ComEngineering/Monitoring_Hardware/Project_PCB/Monitoring_TECO_rev2/DOC/image/BOTT_BACK_view_front.png

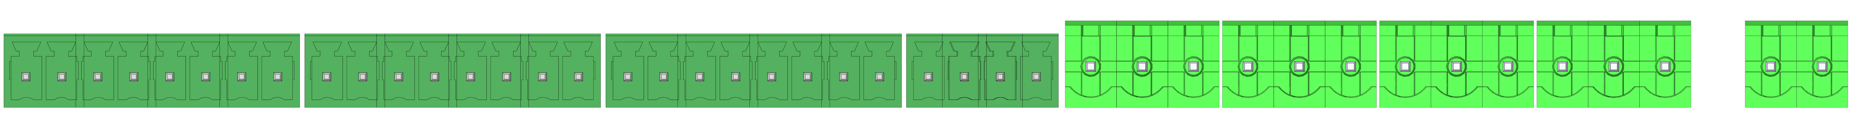
Project_PCB/Monitoring_TECO_rev2/DOC/image/BOTT_BACK_view_front.png
