ComEngineering/Monitoring_Hardware/Project_PCB/Monitoring_TECO_rev2/DOC/image/SM-MOTHB_view_top.png

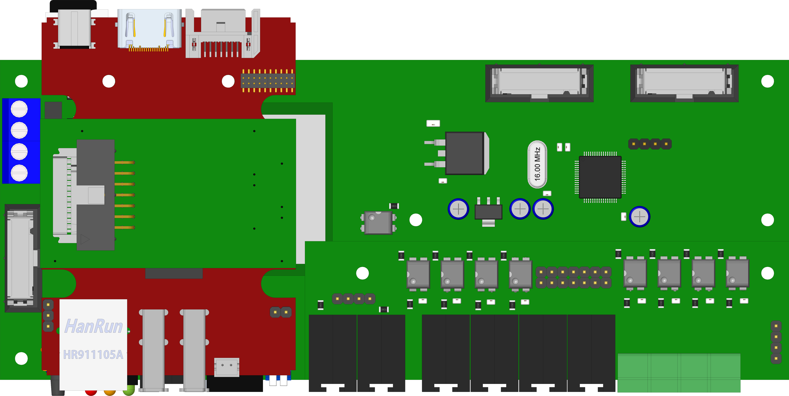
Project_PCB/Monitoring_TECO_rev2/DOC/image/SM-MOTHB_view_top.png
