ComEngineering/Monitoring_Hardware/Project_PCB/Monitoring_TECO_rev2/DOC/image/zGPIO_rev2.png

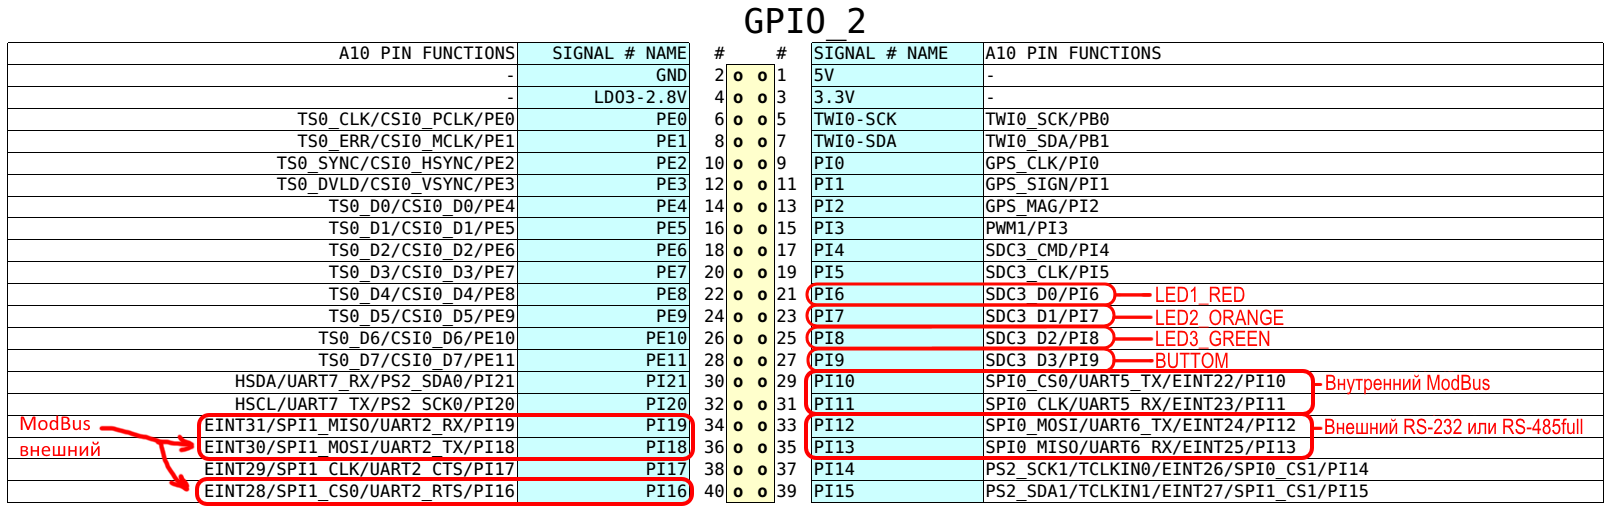
Project_PCB/Monitoring_TECO_rev2/DOC/image/zGPIO_rev2.png
