ComEngineering/Monitoring_Hardware/Project_PCB/Monitoring_TECO_rev2/DOC/Price_SM-DCP4.DCS14 rev. 2.xlsx

Designator | Description | Footprint | Comment | Количество | Цена UAH | Сумма
K1, K2, K3, K4 | 7A 240Vac 1 pole Slim relay | BS-115C-12A | JQC-3F-DC12VH-15A | 4 | 11.25 | 45 | http://www.kosmodrom.com.ua/el.php?name=JQC-3F-DC12VH-15A
K5, K6, K7, K8, K9, K10, K11, K12, K13, K14, K15, K16, K17, K18 | 1A, 10Vdc, 1 pole, SIP terminal | R_BRS | BRS-1A12 | 14 | 25.75 | 360.5 | http://www.kosmodrom.com.ua/el.php?name=BRS-1A12
P1, P2 | IDC/BH | BH-14 | BH-14 | 2 | 1.5 | 3 | http://www.kosmodrom.com.ua/el.php?name=BH-14
U1, U2, U3 | Darlington Transistor Arrays | SO-16_N | ULN2003A | 3 | 3.75 | 11.25 | http://www.kosmodrom.com.ua/prodlist.php?page=0&name=ULN2003A
X1, X2, X3 | Connector 3.5mm | MC_3.5_8 | 15EDGRC-3.5-08P | 3 | 11.25 | 33.75 | http://www.kosmodrom.com.ua/el.php?name=15EDGRC-3.5-08P-14-00AH
X1, X2, X3 | Connector 3.5mm | MC_3.5_8 | 15EDGK-3.5-08P | 3 | 25.75 | 77.25 | http://www.kosmodrom.com.ua/prodlist.php?name=15EDGK-3.5
X4 | Connector 3.5mm | MC_3.5_4 | 15EDGRC-3.5-04P | 1 | 5 | 5 | http://www.kosmodrom.com.ua/el.php?name=15EDGRC-3.5-04P-14-00AH
X4 | Connector 3.5mm | MC_3.5_4 | 15EDGK-3.5-02P | 1 | 7.5 | 7.5 | http://www.kosmodrom.com.ua/prodlist.php?name=15EDGK-3.5
X5, X6, X7, X8 | Connector 5mm | 2EDGR-5.0-03P | 2EDGR-5.0-03P | 4 | 4.5 | 18 | http://www.kosmodrom.com.ua/prodlist.php?name=2EDGR-5.0
X5, X6, X7, X8 | Connector 5mm | 2EDGK-5.0-03P | 2EDGK-5.0-03P | 4 | 12.25 | 49 | http://www.kosmodrom.com.ua/prodlist.php?name=2EDGK-5.0
X9 | Connector 5mm | 2EDGR-5.0-02P | 2EDGR-5.0-02P | 1 | 7.25 | 7.25 | http://www.kosmodrom.com.ua/prodlist.php?name=2EDGR-5.0
X9 | Connector 5mm | 2EDGK-5.0-02P | 2EDGK-5.0-02P | 1 | 8 | 8 | http://www.kosmodrom.com.ua/prodlist.php?name=2EDGK-5.0
X10 | Connector 5mm | 5mm 2 | DG305-5.0-02P | 1 | 3.5 | 3.5 | http://www.kosmodrom.com.ua/el.php?name=DG305-5.0-02P-12-00AH
 |  |  |  |  |  | 629
