ComEngineering/Monitoring_Hardware/Project_PCB/Monitoring_TECO_rev2/DOC/Price_SM-MOTHB rev. 2.xlsx

Designator | Description | Footprint | Comment | Value | Количество | Цена UAH | Сумма
C1, C5, C6, C7 | Capacitor semi | C_1206 | Cap_Semi | 0,47uF | 4 | 1 | 4 | http://www.kosmodrom.com.ua/prodlist.php?name=cap1206
C2, C42 | Capacitor semi | C_0805 | Cap_Semi | 10nF | 2 | 0.25 | 0.5 | http://www.kosmodrom.com.ua/prodlist.php?name=cap0805
C3 | Capacitor Polar | 8x11 | Cap_Polar | 100uF 25v | 1 | 0.75 | 0.75 | http://www.kosmodrom.com.ua/el.php?name=ECAP100MKF25VGS6.3X11
C4 | Capacitor Polar | 10x16 | Cap_Polar | 330uF 25v | 1 | 1.5 | 1.5 | http://www.kosmodrom.com.ua/el.php?name=ECAP330MKF25VKM10X12
C8, C11, C12, C13, C14, C16, C17, C18, C19, C20, C21, C22, C23, C24, C25, C26, C27, C28, C29, C30, C33, C34, C35, C36, C37, C38, C40, C41 | Capacitor semi | C_0805 | Cap_Semi | 0,1uF | 28 | 0.2 | 5.6 | http://www.kosmodrom.com.ua/prodlist.php?name=cap0805
C9, C10, C39, C43 | Capacitor polar | 5x11 | Cap_Polar | 10uF | 4 | 0.5 | 2 | http://www.kosmodrom.com.ua/el.php?name=ECAP10MKF63VSD5X11
C15, C31, C32 | Capacitor semi | C_0805 | Cap_Semi | 20pF | 3 | 0.25 | 0.75 | http://www.kosmodrom.com.ua/prodlist.php?name=cap0805
D1, D3 | Diode Schottky | SMC | VS-30BQ040 |  | 2 | 7.25 | 14.5 | http://www.kosmodrom.com.ua/prodlist.php?page=0&name=VS-30BQ040
D2, D4 | Supressor | SMB | SMBJ13A |  | 2 | 2.75 | 5.5 | http://www.kosmodrom.com.ua/el.php?name=SMBJ13A-TR
D5 | Diode Schottky | DO-201 | 1N5822 |  | 1 | 1.25 | 1.25 | http://www.kosmodrom.com.ua/prodlist.php?page=0&name=1N5822
D6, D7 | Diode Schottky | SOT-23_d | BAT54S |  | 2 | 0.5 | 1 | http://www.kosmodrom.com.ua/prodlist.php?page=0&name=BAT54S
D8, D9 | Supressor | SMB | SMBJ12CA |  | 2 | 3.5 | 7 | http://www.kosmodrom.com.ua/el.php?name=SMBJ12CA-TR
DS1 | LED | LED_RED | LED_RED |  | 1 | 0.75 | 0.75 | http://www.kosmodrom.com.ua/el.php?name=FYL-3004HD
DS2 | LED | LED_YELLOW | LED_YELLOW |  | 1 | 1.75 | 1.75 | http://www.kosmodrom.com.ua/el.php?name=FYL-3014UYC
DS3 | LED | LED_GREEN | LED_GREEN |  | 1 | 0.75 | 0.75 | http://www.kosmodrom.com.ua/el.php?name=FYL-3004GD
DS4, DS5, DS6, DS7 | LED_SMD | LED_SMD_0805 | LED_SMD_0805_Green |  | 4 | 2 | 8 | http://www.kosmodrom.com.ua/el.php?name=FYLS-0805PGC
F1, F2 | Fuse | Fuse RFTQ | RFTQ-2A |  | 2 | 4.25 | 8.5 | http://www.kosmodrom.com.ua/el.php?name=RFTQ-2A
L1 | Inductor | RCH-110 | RCH110NP-470K |  | 1 | 16.5 | 16.5 | http://www.kosmodrom.com.ua/el.php?name=RCH110NP-470K
P1, P2, P3 | IDC/BH | BH-14 | BH-14 |  | 3 | 1.5 | 4.5 | http://www.kosmodrom.com.ua/el.php?name=BH-14
R1 | Resistor | R_0805 | Resistor | 3,3K ±1% | 1 | 0.1 | 0.1 | http://www.kosmodrom.com.ua/prodlist.php?name=RES0805&page=1
R2, R3, R8, R30, R33, R36, R39, R42, R44, R47, R49 | Resistor | R_0805 | Resistor | 1K | 11 | 0.1 | 1.1 | http://www.kosmodrom.com.ua/prodlist.php?name=RES0805&page=0
R4, R16, R17, R21, R29, R32, R35, R38, R41, R43, R45, R48 | Resistor | R_0805 | Resistor | 10K | 12 | 0.1 | 1.2 | http://www.kosmodrom.com.ua/prodlist.php?name=RES0805&page=0
R5 | Resistor | R_0805 | Resistor | 24K ±1% | 1 | 0.1 | 0.1 | http://www.kosmodrom.com.ua/prodlist.php?name=RES0805&page=1
R6, R7, R11, R12 | Resistor | R_1206 | Resistor | 1R | 4 | 0.1 | 0.4 | http://www.kosmodrom.com.ua/prodlist.php?name=res1206
R9, R10 | Resistor | R_0805 | Resistor | 510R | 2 | 0.1 | 0.2 | http://www.kosmodrom.com.ua/prodlist.php?name=RES0805&page=2
R13, R19, R20, R23, R46 | Resistor | R_0805 | Resistor | 4,7K | 5 | 0.1 | 0.5 | http://www.kosmodrom.com.ua/prodlist.php?name=RES0805&page=2
R14, R15, R22, R24, R26 | Resistor | R_0805 | Resistor | 430R | 5 | 0.1 | 0.5 | http://www.kosmodrom.com.ua/prodlist.php?name=RES0805&page=2
R18, R25 | Resistor | R_0805 | Resistor | 2,2K | 2 | 0.1 | 0.2 | http://www.kosmodrom.com.ua/prodlist.php?name=RES0805&page=1
R27, R28 | Resistor | R_1206 | Resistor | 240R | 2 | 0.1 | 0.2 | http://www.kosmodrom.com.ua/prodlist.php?name=RES1206&page=1
R31, R34, R37, R40 | Resistor | R_0805 | Resistor | 2K | 4 | 0.1 | 0.4 | http://www.kosmodrom.com.ua/prodlist.php?name=RES0805&page=1
R50, R51, R52, R53 | Resistor | R_0805 | Resistor | 0R | 4 | 1 | 4 | http://www.kosmodrom.com.ua/prodlist.php?name=res1206
S1 | Swtich | Swich_TACTA-68N-F_ | TACTA-68N-F |  | 1 | 1.75 | 1.75 | http://www.kosmodrom.com.ua/el.php?name=TACTA-68N-F
S2 | DIP Switch_2 | Swich_DIP2 | SW DIP-2 |  | 1 | 5.5 | 5.5 | http://www.kosmodrom.com.ua/el.php?name=SWD3-2
U1 | Easy Switcher 3.0A Step-Down Voltage Regulator | D2PAK_5p | LM2596SX-ADJ |  | 1 | 50.75 | 50.75 | http://www.kosmodrom.com.ua/el.php?name=LM2596SX-ADJ
U2 | Voltage Regulators | D2PAK_3p | L7805ABD2T |  | 1 | 8.25 | 8.25 | http://www.kosmodrom.com.ua/el.php?name=L7805ABD2T-TR
U3 | Voltage Regulators 800mA | SOT-223_N | LD1117AS33TR |  | 1 | 2.5 | 2.5 | http://www.kosmodrom.com.ua/el.php?name=LD1117AS33TR
U4 | DC/DC converter | SIP4 | B1205S-1W |  | 1 | 63.5 | 63.5 | http://www.kosmodrom.com.ua/el.php?name=B1205S-1W
U5, U13, U14, U17, U18, U19, U20, U21, U22 | Optocoupler | DIP-4 | PC817C |  | 9 | 2 | 18 | http://www.kosmodrom.com.ua/el.php?name=PC817C
U6 | Dual Comparators | SO-8_L | LM393DR2G |  | 1 | 2.5 | 2.5 | http://www.kosmodrom.com.ua/el.php?name=LM393DR2G
U7 | DC/DC Regulated Single Output | NSD05 | NSD05-12S12 |  | 1 | 212 | 212 | http://psu.kiev.ua/p38435065-blok-pitaniya-mean.html
U8 | Optocoupler | DIP-8 | 6N137 |  | 1 | 10.5 | 10.5 | http://www.kosmodrom.com.ua/el.php?name=6N137
U9 | RS-485/RS-422 Transceiver | SO-8_N | ST485BDR |  | 1 | 7.75 | 7.75 | http://www.kosmodrom.com.ua/el.php?name=ST485BDR
U10, U12 | Dual-Channel Digital Isolators | SO-8_N | ADuM1201 |  | 2 | 25.5 | 51 | http://www.kosmodrom.com.ua/el.php?name=ADUM1201A
U11 | RS485/RS422 Differential driver and receiver pair | SO-8_L | SN75179B |  | 1 | 7.5 | 7.5 | http://www.kosmodrom.com.ua/el.php?name=SN75179BD
U15 | RS-232 Transceiver | SO-16_N | MAX3232EIDR |  | 1 | 22.5 | 22.5 | http://www.kosmodrom.com.ua/el.php?name=MAX3232EIDR
U16 | ARM Cortex-M0 32-bit MCU, 64 KB Flash, 8 KB Internal RAM, 55 I/Os, 64-pin LQFP, -40 to 85 degC, Tray | LQFP64_L | STM32F030R8T6 |  | 1 | 57.75 | 57.75 | http://www.kosmodrom.com.ua/el.php?name=STM32F030R8T6
VT1, VT2, VT3 | NPN | SOT-23_N | BC817 |  | 3 | 0.5 | 1.5 | http://www.kosmodrom.com.ua/el.php?name=BC817-40LT3G
X1, X2 | Connector 5mm | 5mm 2 | DG305-5.0-02P |  | 2 | 3.5 | 7 | http://www.kosmodrom.com.ua/el.php?name=DG305-5.0-02P-12-00AH
X4, X5, X6, X7 | Jumper | JUMPER-G | JUMPER-G |  | 4 | 0.5 | 2 | http://www.kosmodrom.com.ua/el.php?name=JUMPER-G
X3, X8, X11, X12 | Header, 14-Pin | ZL2029 | ZL2029 |  | 2 | 16.25 | 32.5 | http://www.kosmodrom.com.ua/el.php?name=ZL2029-20
X4, X5, X6, X7, X10 | Header, 16-pin | ZL201-16G | ZL201-16G |  | 1 | 16.25 | 16.25 | http://www.kosmodrom.com.ua/el.php?name=ZL201-16G
X9 | Connector 3.5mm | MC_3.5_8 | 15EDGRC-3.5-08P |  | 1 | 11.25 | 11.25 | http://www.kosmodrom.com.ua/el.php?name=15EDGRC-3.5-08P-14-00AH
X9 | Connector 3.5mm | MC_3.5_8 | 15EDGK-3.5-08P |  | 1 | 25.75 | 25.75 | http://www.kosmodrom.com.ua/prodlist.php?name=15EDGK-3.5
XS1, XS2, XS5, XS6, XS7, XS8 | TJ4-4P4C | RJ-11 - TJ4-4P4C | TJ4-4P4C |  | 6 | 4.5 | 27 | http://www.kosmodrom.com.ua/el.php?name=TJ4-4P4C
XS3 | TJ4-6P6C | RJ-12 - TJ4-6P6C | TJ4-6P6C |  | 1 | 4 | 4 | http://www.kosmodrom.com.ua/el.php?name=TJ4-6P6C
XS4 | Connector RJ-45 Simple | RJ-45 - TJ4-8P8C | TJ4-6P6C |  | 1 | 7.5 | 7.5 | http://www.kosmodrom.com.ua/el.php?name=TJ4-8P8C
ZQ1 | Crystal Oscillator | HC49S_3D | 8MHz |  | 1 | 5.5 | 5.5 | http://www.kosmodrom.com.ua/prodlist.php?page=0&name=HC49S
 | Connector IDC |  | AWP-14ZZ |  | 6 | 4.75 | 28.5 | http://www.kosmodrom.com.ua/el.php?name=AWP-14ZZ
 | Шлейф плоский |  | FLC-14 |  | 1 | 15.75 | 15.75 | http://www.kosmodrom.com.ua/el.php?name=FLC-14
 | RJ-11 Ответка |  | RJ11W-R |  | 12 | 1.5 | 18 | http://www.kosmodrom.com.ua/el.php?name=RJ11W-R
 | RJ-12 Ответка |  | RJ12W-R |  | 1 | 1.5 | 1.5 | http://www.kosmodrom.com.ua/el.php?name=RJ12W-R
 | RJ-45 Ответка |  | EMP881AR200 |  | 2 | 3 | 6 | http://www.kosmodrom.com.ua/el.php?name=EMP881AR200
 | Cтойка монтажная TP-15 пластиковая винт-гайка М3 |  | TP-15 |  | 4 | 3 | 12 | http://voron.ua/catalog/001230
 | Винт М3х08мм пластик молочный гол. полукруг |  | М3х08мм |  | 4 | 1 | 4 | http://voron.ua/catalog/016228
 | Гайка М3 шестигранная, пластиковая |  | М3 |  | 4 | 1 | 4 | http://voron.ua/catalog/016143
 | Держатель светодиода 3мм угловой одинарный |  |  |  | 3 | 0.36 | 1.08 | http://voron.ua/catalog/016137
P1 | IDC/BH | BH-14R | BH-14R |  | 1 | 4.75 | 4.75 | http://www.kosmodrom.com.ua/el.php?name=BH-14R
X1, X2, X3, X4 | Header, 20-Pin | PBD2-1.27-20-SMD | PBD2-20 |  | 4 | 5 | 20 | http://www.sea.com.ua/item/199202
 |  |  |  |  |  |  | 831.73
