ComEngineering/Monitoring_Hardware/Project_PCB/Monitoring_TECO_rev2/DOC/Price_SM-OW2.DI4.DCI4 rev. 2.xlsx

Designator | Description | Footprint | Comment | Value | Количество | Цена UAH | Сумма
C1, C2, C3, C4, C5, C6, C7, C8, C9, C10 | Capacitor semi | C_0805 | Cap_Semi | 0,1uF | 10 | 0.2 | 2 | http://www.kosmodrom.com.ua/prodlist.php?name=cap0805
D1, D2 | Diode Schottky | SOT-23_d | BAT54S |  | 2 | 0.5 | 1 | http://www.kosmodrom.com.ua/prodlist.php?page=0&name=BAT54S
DS1, DS2, DS3, DS4 | LED_SMD | LED_SMD_0805 | LED_SMD_0805_Green |  | 4 | 2 | 8 | http://www.kosmodrom.com.ua/el.php?name=FYLS-0805PGC
R1, R2 | Resistor | R_0805 | Resistor | 2,2K | 2 | 0.1 | 0.2 | http://www.kosmodrom.com.ua/prodlist.php?name=RES0805&page=1
R3, R6, R9, R12, R15, R17, R19, R21 | Resistor | R_0805 | Resistor | 10K | 8 | 0.1 | 0.8 | http://www.kosmodrom.com.ua/prodlist.php?name=RES0805&page=0
R4, R7, R10, R13, R16, R18, R20, R22 | Resistor | R_0805 | Resistor | 1K | 8 | 0.1 | 0.8 | http://www.kosmodrom.com.ua/prodlist.php?name=RES0805&page=0
R5, R8, R11, R14 | Resistor | R_0805 | Resistor | 2K | 4 | 0.1 | 0.4 | http://www.kosmodrom.com.ua/prodlist.php?name=RES0805&page=1
U1, U2, U3, U4, U5, U6, U7, U8 | Optocoupler | DIP-4 | PC817C |  | 8 | 2 | 16 | http://www.kosmodrom.com.ua/el.php?name=PC817C
X3 | Connector 3.5mm | MC_3.5_8 | 15EDGRC-3.5-08P |  | 1 | 11.25 | 11.25 | http://www.kosmodrom.com.ua/el.php?name=15EDGRC-3.5-08P-14-00AH
X3 | Connector 3.5mm | MC_3.5_8 | 15EDGK-3.5-08P |  | 1 | 25.75 | 25.75 | http://www.kosmodrom.com.ua/prodlist.php?name=15EDGK-3.5
XS1, XS2, XS3, XS4, XS5, XS6 | TJ4-4P4C | RJ-11 - TJ4-4P4C | TJ4-4P4C |  | 6 | 4.5 | 27 | http://www.kosmodrom.com.ua/el.php?name=TJ4-4P4C
 |  |  |  |  |  |  | 93.2
