ComEngineering/Monitoring_Hardware/Project_PCB/Monitoring_TECO_rev2/DOC/Закупка_Monitoring_TECO.xlsx

Designator | Description | Footprint | Comment | Value | Количество | Цена UAH | Сумма
C1, C5, C6, C48 | Capacitor semi | C_1206 | Cap_Semi | 0,47uF | 4 | 1 | 4 | http://www.kosmodrom.com.ua/prodlist.php?name=cap1206
C2, C43 | Capacitor semi | C_0805 | Cap_Semi | 10nF | 2 | 0.25 | 0.5 | http://www.kosmodrom.com.ua/prodlist.php?name=cap0805
C3 | Capacitor Polar | 8x11 | Cap_Polar | 100uF 25v | 1 | 0.75 | 0.75 | http://www.kosmodrom.com.ua/el.php?name=ECAP100MKF25VGS6.3X11
C4 | Capacitor Polar | 10x16 | Cap_Polar | 330uF 25v | 1 | 2 | 2 | http://www.kosmodrom.com.ua/el.php?name=ECAP330MKF25VKM10X12
C7, C10, C11, C12, C13, C14, C16, C17, C18, C19, C22, C23, C24, C25, C26, C27, C29, C31, C32, C33, C34, C35, C36, C37, C38, C39, C41, C42, C45, C46, C47 | Capacitor semi | C_0805 | Cap_Semi | 0,1uF | 31 | 0.2 | 6.2 | http://www.kosmodrom.com.ua/prodlist.php?name=cap0805
C8, C9, C40, C44 | Capacitor polar | 5x11 | Cap_Polar | 10uF | 4 | 0.75 | 3 | http://www.kosmodrom.com.ua/el.php?name=ECAP10MKF63VSD5X11
C15, C28, C30 | Capacitor semi | C_0805 | Cap_Semi | 20pF | 3 | 0.25 | 0.75 | http://www.kosmodrom.com.ua/prodlist.php?name=cap0805
C20, C21 | Capacitor Semi | C_0805 | Cap_Semi | 2,2nF | 2 | 0.25 | 0.5 | http://www.kosmodrom.com.ua/prodlist.php?name=cap0805
D1, D1.1 | Diode Schottky | SMC | VS-30BQ040 |  | 2 | 6.5 | 13 | http://www.kosmodrom.com.ua/prodlist.php?page=0&name=VS-30BQ040
D2, D3 | Supressor | SMB | SMBJ15A |  | 2 | 1.75 | 3.5 | http://www.kosmodrom.com.ua/el.php?name=SMBJ15A-TR
D4 | Diode Schottky | DO-201 | 1N5822 |  | 1 | 1.75 | 1.75 | http://www.kosmodrom.com.ua/prodlist.php?page=0&name=1N5822
D5, D6 | Diode Schottky | SOT-23_d | BAT54S |  | 2 | 0.5 | 1 | http://www.kosmodrom.com.ua/prodlist.php?page=0&name=BAT54S
D7, D8 | Supressor | SMB | SMBJ12CA |  | 2 | 3.25 | 6.5 | http://www.kosmodrom.com.ua/el.php?name=SMBJ12CA-TR
DS1, DS3 | LED | LED_RED | FYL-3004HD |  | 2 | 0.75 | 1.5 | http://www.kosmodrom.com.ua/el.php?name=FYL-3004HD
DS2 | LED | LED_GREEN | FYL-3004GD |  | 1 | 0.75 | 0.75 | http://www.kosmodrom.com.ua/el.php?name=FYL-3004GD
F1 | Fuse | Fuse RFTQ | RFTQ-2.5A |  | 1 | 4.25 | 4.25 | http://www.kosmodrom.com.ua/el.php?name=RFTQ-2.5A
F2, F3 | Fuse | Fuse RFTQ | RFTQ-0.16A |  | 2 | 5.5 | 11 | http://www.kosmodrom.com.ua/el.php?name=RFTQ-0.16A
F4, F5 | Fuse | Fuse RFTQ | RFTQ-1A |  | 2 | 4.25 | 8.5 | http://www.kosmodrom.com.ua/el.php?name=RFTQ-1A
K1, K2, K3, K4, K5, K6, K7, K8, K9, K10, K11, K12, K13, K14 | 1A, 10Vdc, 1 pole, SIP terminal | R_BRS | BRS-1A12 |  | 14 | 23.5 | 329 | http://www.kosmodrom.com.ua/el.php?name=BRS-1A12
K15, K16, K17, K18 | 7A 240Vac 1 pole Slim relay | BS-115C-12A | JQC-3F-DC12VH-15A |  | 4 | 10.25 | 41 | http://www.kosmodrom.com.ua/el.php?name=JQC-3F-DC12VH-15A
L1 | Inductor | RCH-110 | RCH110NP-470K |  | 1 | 15 | 15 | http://www.kosmodrom.com.ua/el.php?name=RCH110NP-470K
P1, P2, P3, P4, P5 | IDC/BH | BH-14 | BH-14 |  | 5 | 2.5 | 12.5 | http://www.kosmodrom.com.ua/el.php?name=BH-14
P6 | IDC/BH | BH-14R | BH-14R |  | 1 | 4.75 | 4.75 | http://www.kosmodrom.com.ua/el.php?name=BH-14R
R1 | Resistor | R_0805 | Resistor | 3,3K ±1% | 1 | 0.1 | 0.1 | http://www.kosmodrom.com.ua/prodlist.php?name=RES0805&page=1
R2, R3, R13, R15, R19, R23, R25, R27, R29, R31, R34, R36, R38, R40, R42, R44, R48, R51, R53 | Resistor | R_0805 | Resistor | 1K | 19 | 0.06 | 1.14 | http://www.kosmodrom.com.ua/prodlist.php?name=RES0805&page=0
R4, R12, R14, R16, R17, R18, R22, R24, R26, R28, R30, R33, R35, R37, R39, R41, R43, R47, R50, R54, R55, R56 | Resistor | R_0805 | Resistor | 10K | 22 | 0.1 | 2.2 | http://www.kosmodrom.com.ua/prodlist.php?name=RES0805&page=0
R5 | Resistor | R_0805 | Resistor | 24K ±1% | 1 | 0.1 | 0.1 | http://www.kosmodrom.com.ua/prodlist.php?name=RES0805&page=1
R6, R7, R10, R11 | Resistor | R_1206 | Resistor | 1R | 4 | 0.1 | 0.4 | http://www.kosmodrom.com.ua/prodlist.php?name=res1206
R8, R9 | Resistor | R_0805 | Resistor | 510R | 2 | 0.1 | 0.2 | http://www.kosmodrom.com.ua/prodlist.php?name=RES0805&page=2
R20, R21 | Resistor | R_0805 | Resistor | 3,9K ±1% | 2 | 0.1 | 0.2 | http://www.kosmodrom.com.ua/prodlist.php?name=RES0805&page=1
R32, R52, R59, R60, R61 | Resistor | R_0805 | Resistor | 360R | 5 | 0.1 | 0.5 | http://www.kosmodrom.com.ua/prodlist.php?name=RES0805&page=2
R45, R49 | Resistor | R_0805 | Resistor | 2,2K | 2 | 0.06 | 0.12 | http://www.kosmodrom.com.ua/prodlist.php?name=RES0805&page=1
R46 | Resistor | R_0805 | Resistor | 4,7K | 1 | 0.1 | 0.1 | http://www.kosmodrom.com.ua/prodlist.php?name=RES0805&page=2
R57, R58 | Resistor | R_1206 | Resistor | 240R ±1% | 2 | 0.14 | 0.28 | http://www.kosmodrom.com.ua/prodlist.php?name=RES1206&page=1
S1 | DIP Switch_2 | Swich_DIP2 | SWD3-2 |  | 1 | 5 | 5 | http://www.kosmodrom.com.ua/el.php?name=SWD3-2
S2 | Swtich | Swich_TACTA-68N-F_ | TACTA-68N-F |  | 1 | 1.5 | 1.5 | http://www.kosmodrom.com.ua/el.php?name=TACTA-68N-F
U1 | Easy Switcher 3.0A Step-Down Voltage Regulator | D2PAK_5p | LM2596SX-ADJ |  | 1 | 46.5 | 46.5 | http://www.kosmodrom.com.ua/el.php?name=LM2596SX-ADJ
U2 | Voltage Regulators 800mA | SOT-223_N | LD1117AS33TR |  | 1 | 2 | 2 | http://www.kosmodrom.com.ua/el.php?name=LD1117AS33TR
U3 | Voltage Regulators | D2PAK_3p | L7805ABD2T |  | 1 | 8 | 8 | http://www.kosmodrom.com.ua/el.php?name=L7805ABD2T-TR
U4 | DC/DC converter | SIP4 | B1205S-1W |  | 1 | 58.25 | 58.25 | http://www.kosmodrom.com.ua/el.php?name=B1205S-1W
U5, U8, U9, U10, U11, U12, U13, U14, U15, U18, U20, U21, U23, U24, U25, U26, U27 | Optocoupler | DIP-4 | PC817C |  | 17 | 2 | 34 | http://www.kosmodrom.com.ua/el.php?name=PC817C
U6 | Dual Comparators | SO-8_L | LM393DR2G |  | 1 | 2.25 | 2.25 | http://www.kosmodrom.com.ua/el.php?name=LM393DR2G
U7 | DC/DC Regulated Single Output | NSD05 | NSD05-12S12 |  | 1 | 195 | 195 | http://psu.kiev.ua/p38435065-blok-pitaniya-mean.html
U16 | ARM Cortex-M0 32-bit MCU, 64 KB Flash, 8 KB Internal RAM, 55 I/Os, 64-pin LQFP, -40 to 85 degC, Tray | LQFP64_L | STM32F030R8T6 |  | 1 | 50 | 50 | http://www.kosmodrom.com.ua/el.php?name=STM32F030R8T6
U17, U19, U22 | Darlington Transistor Arrays | SO-16_N | ULN2003A |  | 3 | 3.75 | 11.25 | http://www.kosmodrom.com.ua/prodlist.php?page=0&name=ULN2003A
U28 | Optocoupler | DIP-8 | 6N137 |  | 1 | 9.5 | 9.5 | http://www.kosmodrom.com.ua/el.php?name=6N137
U29 | RS-485/RS-422 Transceiver | SO-8_N | ST485BDR |  | 1 | 8.75 | 8.75 | http://www.kosmodrom.com.ua/el.php?name=ST485BDR
U30, U31 | Dual-Channel Digital Isolators | SO-8_N | ADuM1201 |  | 2 | 25.5 | 51 | http://www.kosmodrom.com.ua/el.php?name=ADUM1201A
U32 | RS485/RS422 Differential driver and receiver pair | SO-8_L | SN75179B |  | 1 | 7 | 7 | http://www.kosmodrom.com.ua/el.php?name=SN75179BD
X1, X2 | Connector 5mm | 5mm 2 | DG300-5.0-02P |  | 2 | 3.5 | 7 | http://www.kosmodrom.com.ua/el.php?name=DG300-5.0-02P-12-00AH
X3, X20, X13, X22 | Header, 4-Pin | PLS-4-3D | ZL2029 |  | 2 | 14.75 | 29.5 | http://www.kosmodrom.com.ua/el.php?name=ZL2029-20
X4, X5 | Header, 20-Pin | PBD2-1.27-20-SMD | PBD1.27-20-SMD |  | 2 | 5 | 10 | http://www.sea.com.ua/item/199202
X7, X8, X15, X19, X26 | Connector 3.5mm | MC_3.5_8 | 15EDGRC-3.5-08P |  | 5 | 10.5 | 52.5 | http://www.kosmodrom.com.ua/el.php?name=15EDGRC-3.5-08P-14-00AH
X10, X11, X12, X14 | Connector 5mm | 2EDGR-5.0-03P | 2EDGR-5.0-03P |  | 4 | 4 | 16 | http://www.kosmodrom.com.ua/prodlist.php?name=2EDGR-5.0
X16 | Header, 8-Pin | PLS-8-3D | ZL201-08G |  | 1 | 1.25 | 1.25 | http://www.kosmodrom.com.ua/el.php?name=ZL201-08G
X25 | Connector 3.5mm | MC_3.5_4 | 15EDGRC-3.5-04P |  | 1 | 4.5 | 4.5 | http://www.kosmodrom.com.ua/el.php?name=15EDGRC-3.5-04P-14-00AH
XS1, XS2, XS3, XS4, XS5, XS6, XS7, XS8, XS11, XS12, XS13, XS14 | TJ4-4P4C | RJ-11 | TJ4-4P4C |  | 12 | 3.75 | 45 | http://www.kosmodrom.com.ua/el.php?name=TJ4-4P4C
XS9, XS10 | TJ4-6P6C | RJ-12 | TJ4-6P6C |  | 2 | 3.5 | 7 | http://www.kosmodrom.com.ua/el.php?name=TJ4-6P6C
ZQ1 | Crystal Oscillator | 8.0 MHz | KX-3HE 8.0 MHz |  | 1 | 8.5 | 8.5 | http://www.kosmodrom.com.ua/prodlist.php?name=geyertermostab&page=0
 | Connector 5mm |  | 2EDGK-5.0-03P |  | 4 | 11.25 | 45 | http://www.kosmodrom.com.ua/prodlist.php?name=2EDGK-5.0
 | Connector 3.5mm |  | 15EDGK-3.5-04P |  | 1 | 14.75 | 14.75 | http://www.kosmodrom.com.ua/prodlist.php?name=15EDGK-3.5
 | Connector 3.5mm |  | 15EDGK-3.5-08P |  | 5 | 23.75 | 118.75 | http://www.kosmodrom.com.ua/prodlist.php?name=15EDGK-3.5
 | Connector IDC |  | AWP-14ZZ |  | 6 | 4.75 | 28.5 | http://www.kosmodrom.com.ua/el.php?name=AWP-14ZZ
 | Шлейф плоский |  | FLC-14 |  | 1 | 15.75 | 15.75 | http://www.kosmodrom.com.ua/el.php?name=FLC-14
 | Cтойка монтажная TP-18 пластиковая винт-гайка М3 |  | TP-15 |  | 3 | 3 | 9 | http://voron.ua/catalog/001230
 | Винт М3х08мм пластик молочный гол. полукруг |  | М3х08мм |  | 3 | 1 | 3 | http://voron.ua/catalog/016228
 | Гайка М3 шестигранная, пластиковая |  | М3 |  | 3 | 1 | 3 | http://voron.ua/catalog/016143
 | Держатель светодиода 3 мм угловой двойной |  |  |  | 1 | 0.6 | 0.6 | http://voron.ua/catalog/016138
 | Держатель светодиода 3мм угловой одинарный |  |  |  | 1 | 0.36 | 0.36 | http://voron.ua/catalog/016137
Итого |  |  |  |  |  |  | 1387
