ComEngineering/Monitoring_Hardware/Project_PCB/Monitoring_TECO/PCB_monitoring_Top_Front.step

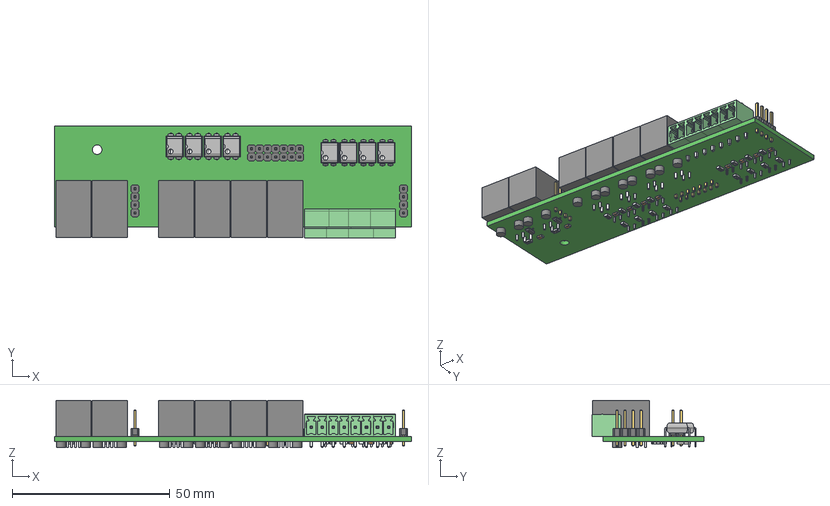
[picture p8: CAD file, 2015-11-30, an earlier design]
Project_PCB/Monitoring_TECO/PCB_monitoring_Top_Front.step
113.0 x 35.4 x 15.0 mm
Board
PLS-1 x 22
0805_SMD_Capacitor x 10
SOT-23 x 2
Resistor_0805 x 18
DIP-4_DEFAULT x 8
15EDGRC-3_5-2 x 4
Extruded x 6
