ComEngineering/Monitoring_Hardware/(list of files, cad)

Other CAD files:
Project_PCB/Monitoring_TECO_rev2/z_Bott_Back/PCB_monitoring_Bott_Back.sldasm
