ComEngineering/Monitoring_Hardware/Project_PCB/Monitoring_TECO_rev2/Project Outputs for Monitoring_TECO_rev2/Shem_monitoring.PDF

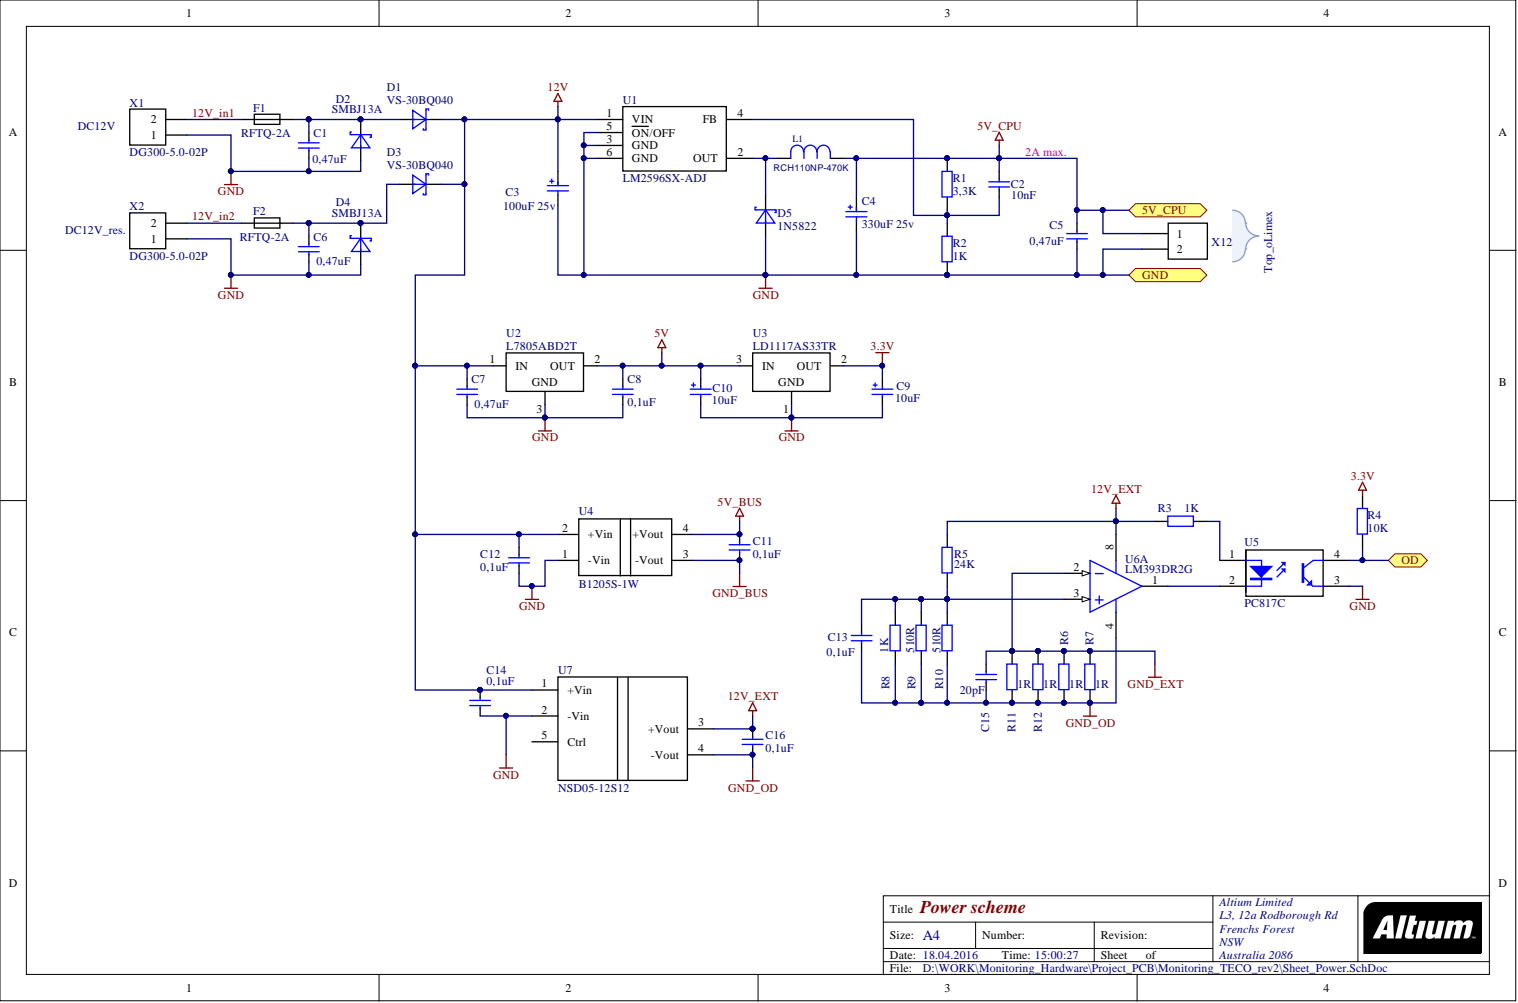
[picture p9: page 1]

C1 DC12V 0,47uF | | ON/OFF 5

GND 3

D4 SMBJ13A

+Vin 2

0,1uF C14 | -Vin 1

+Vin 1

Ctrl 5

Title Power scheme | Altium Limited L3, 12a Rodborough Rd Frenchs Forest NSW Australia 2086

Size: A4 | Number: | Revision:
Date: 18.04.2016 Time: 15:00:27 | | Sheet of

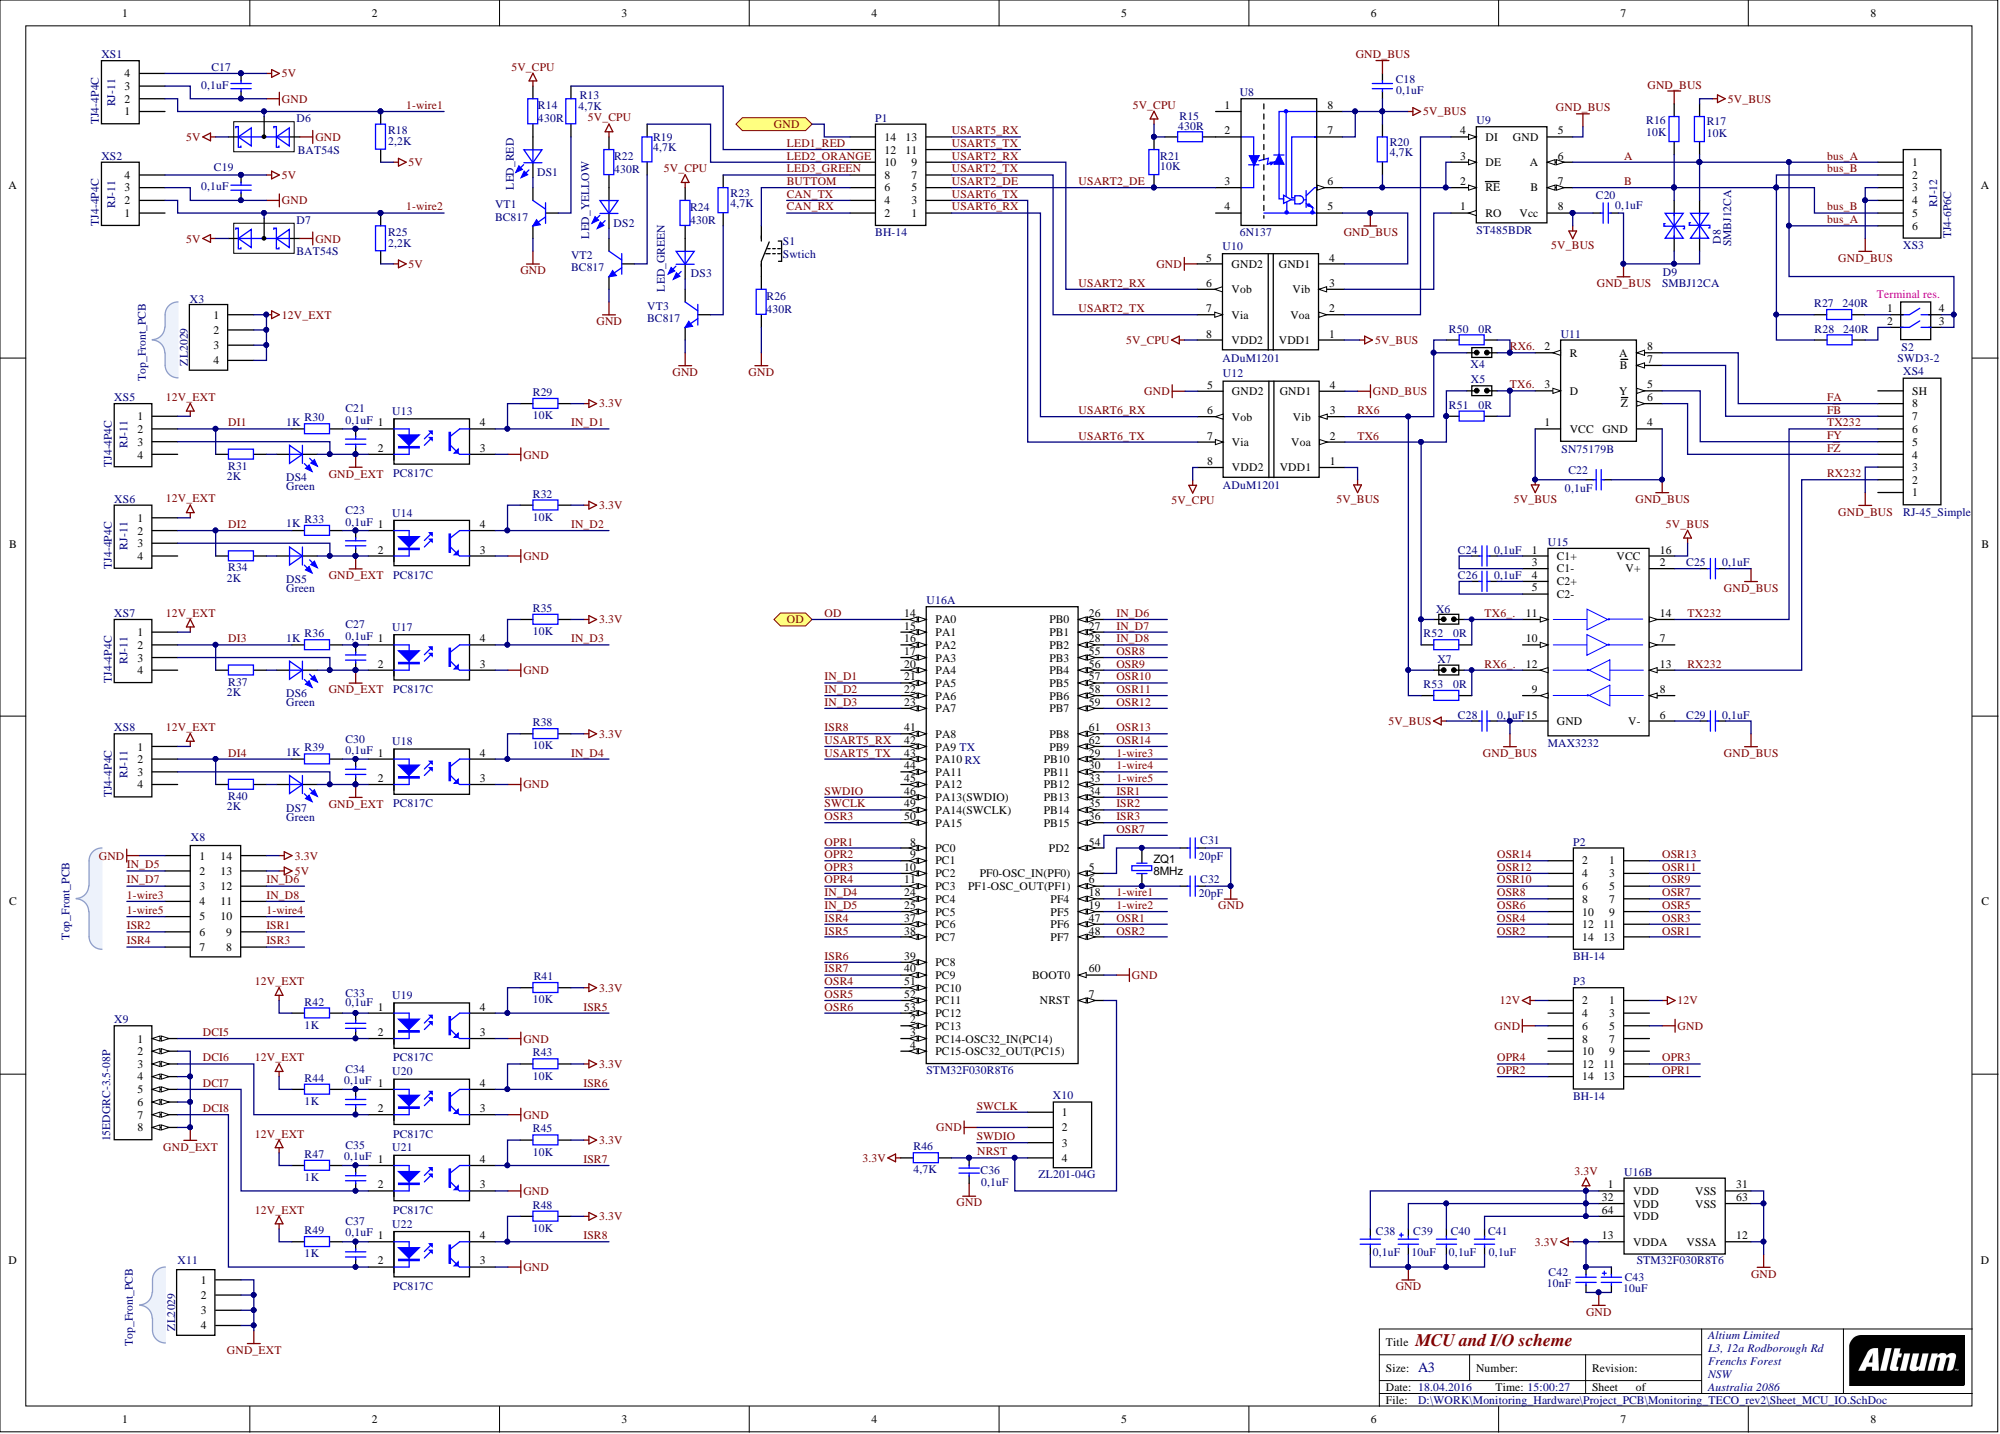
[picture p10: page 2]

GND1 Vib | 4 GND2 5

Vob 6 | | 3

USART2_TX | Via 7

USART6_RX | VDD2 8

Title MCU and I/O scheme | Altium Limited L3, 12a Rodborough Rd Frenchs Forest NSW Australia 2086

Size: A3 | Number: | Revision:
Date: 18.04.2016 Time: 15:00:27 | | Sheet of
