ComEngineering/Monitoring_Hardware/Project_PCB/Monitoring_TECO_rev2/DOC/Sheet_SM-MOTHB rev. 2.PDF

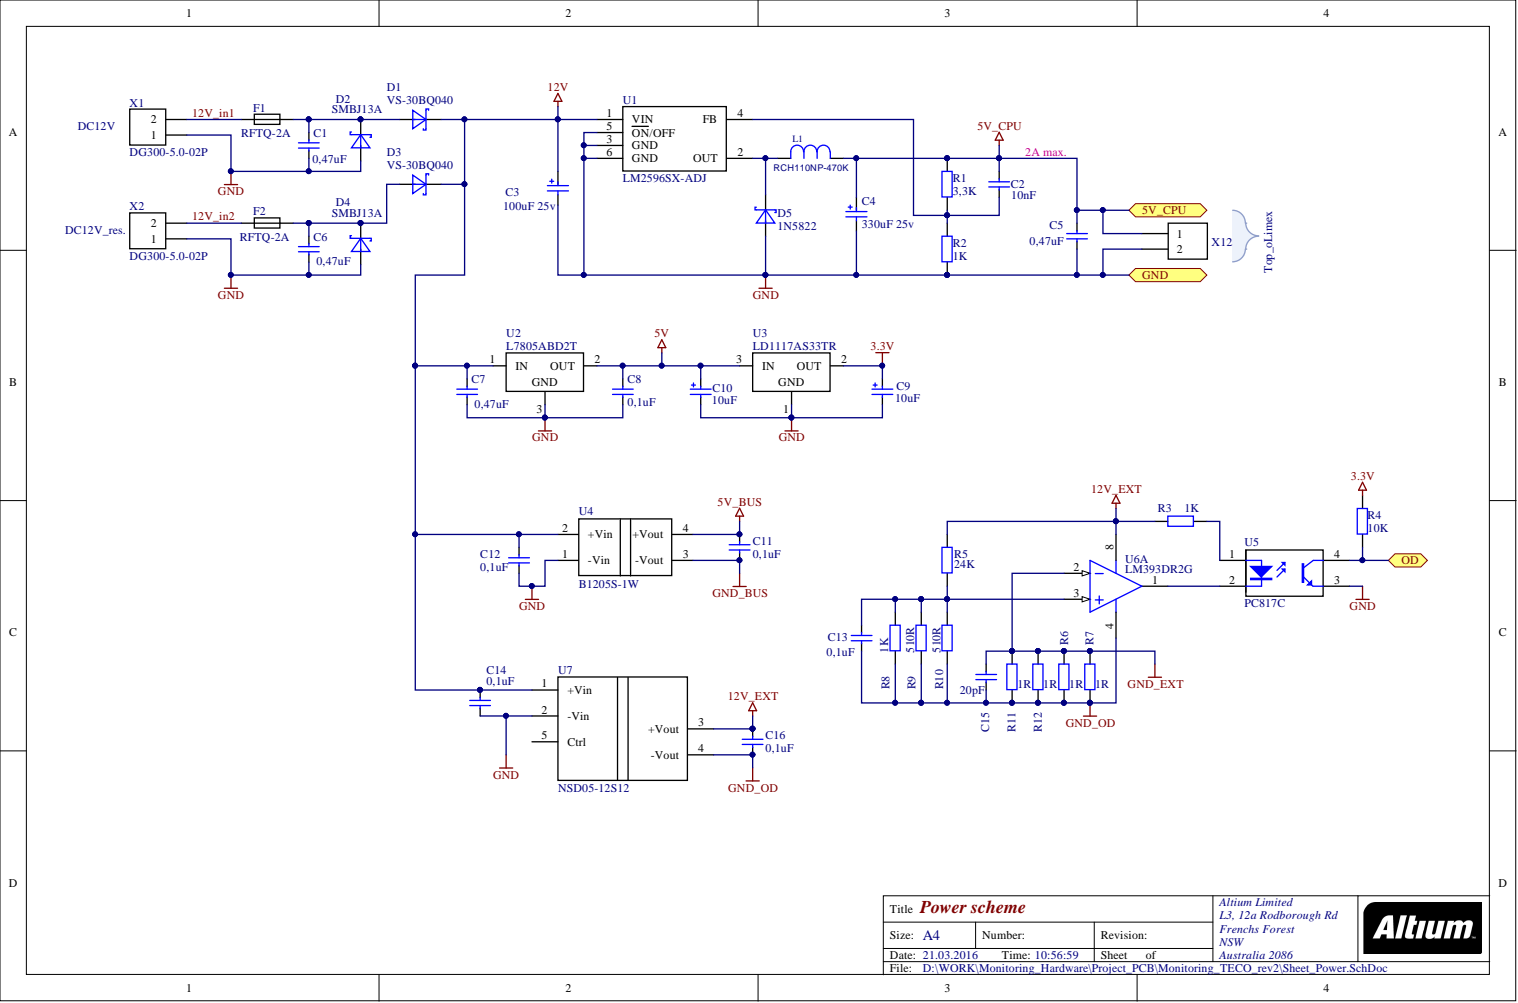
[picture p11: page 1]

C1 DC12V 0,47uF | | ON/OFF 5

GND 3

D4 SMBJ13A

+Vin 2

0,1uF C14 | -Vin 1

+Vin 1

Ctrl 5

Title Power scheme | Altium Limited L3, 12a Rodborough Rd Frenchs Forest NSW Australia 2086

Size: A4 | Number: | Revision:
Date: 21.03.2016 Time: 10:56:59 | | Sheet of

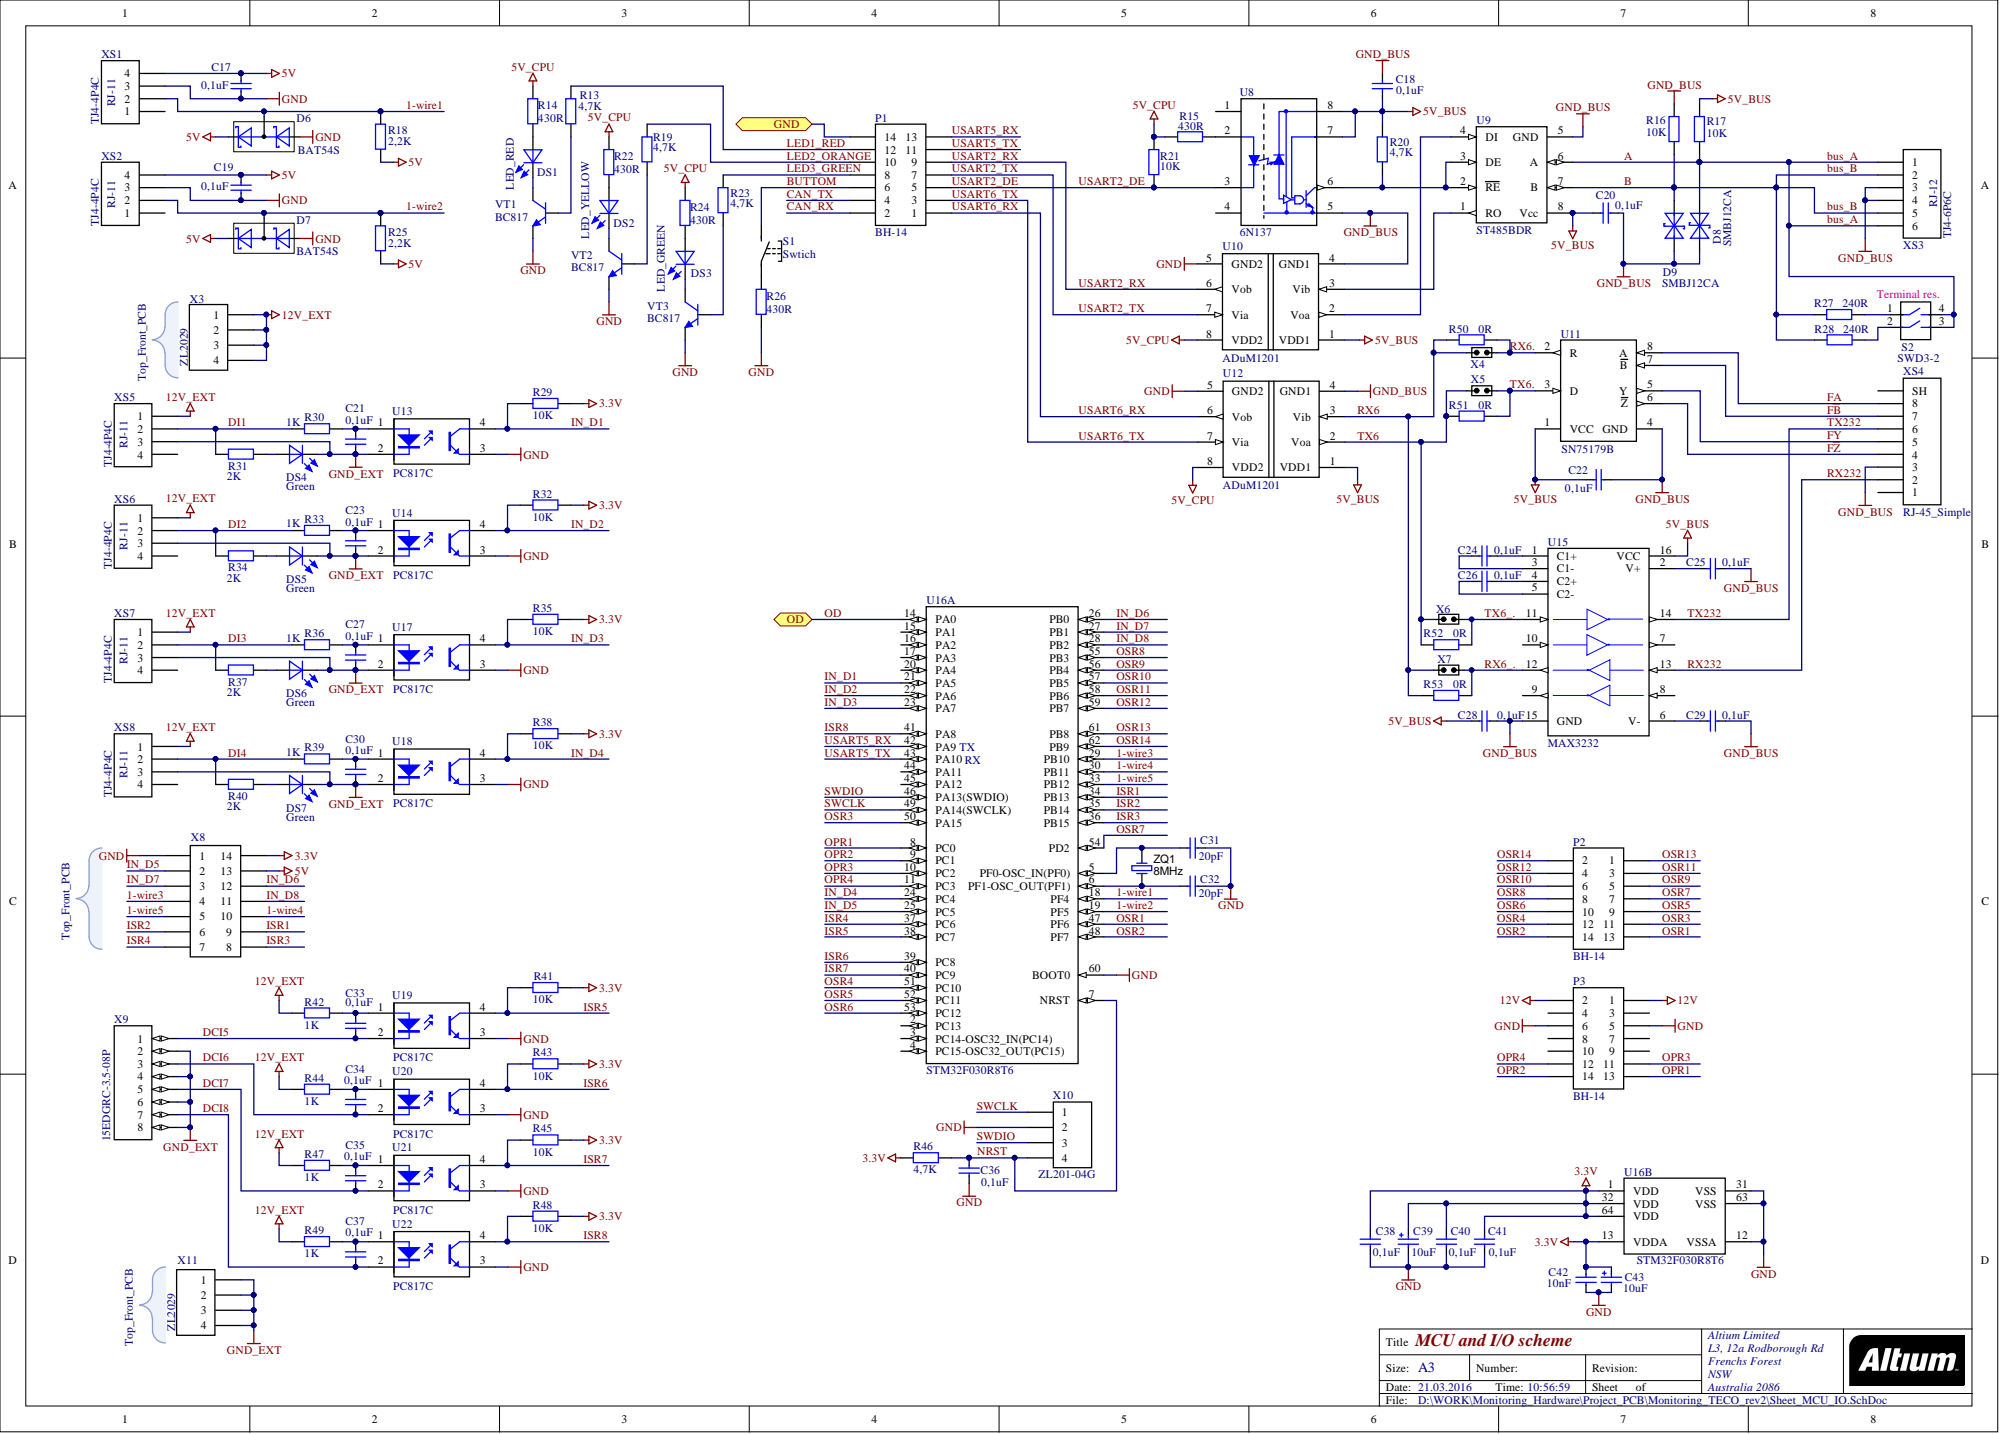
[picture p12: page 2]

GND1 Vib | 4 GND2 5

Vob 6 | | 3

USART2_TX | Via 7

USART6_RX | VDD2 8

Title MCU and I/O scheme | Altium Limited L3, 12a Rodborough Rd Frenchs Forest NSW Australia 2086

Size: A3 | Number: | Revision:
Date: 21.03.2016 Time: 10:56:59 | | Sheet of
