ComEngineering/Monitoring_Hardware/Project_PCB/Monitoring_TECO_rev2/DOC/Sheet_SM-DCP4.DCS14 rev. 2.PDF

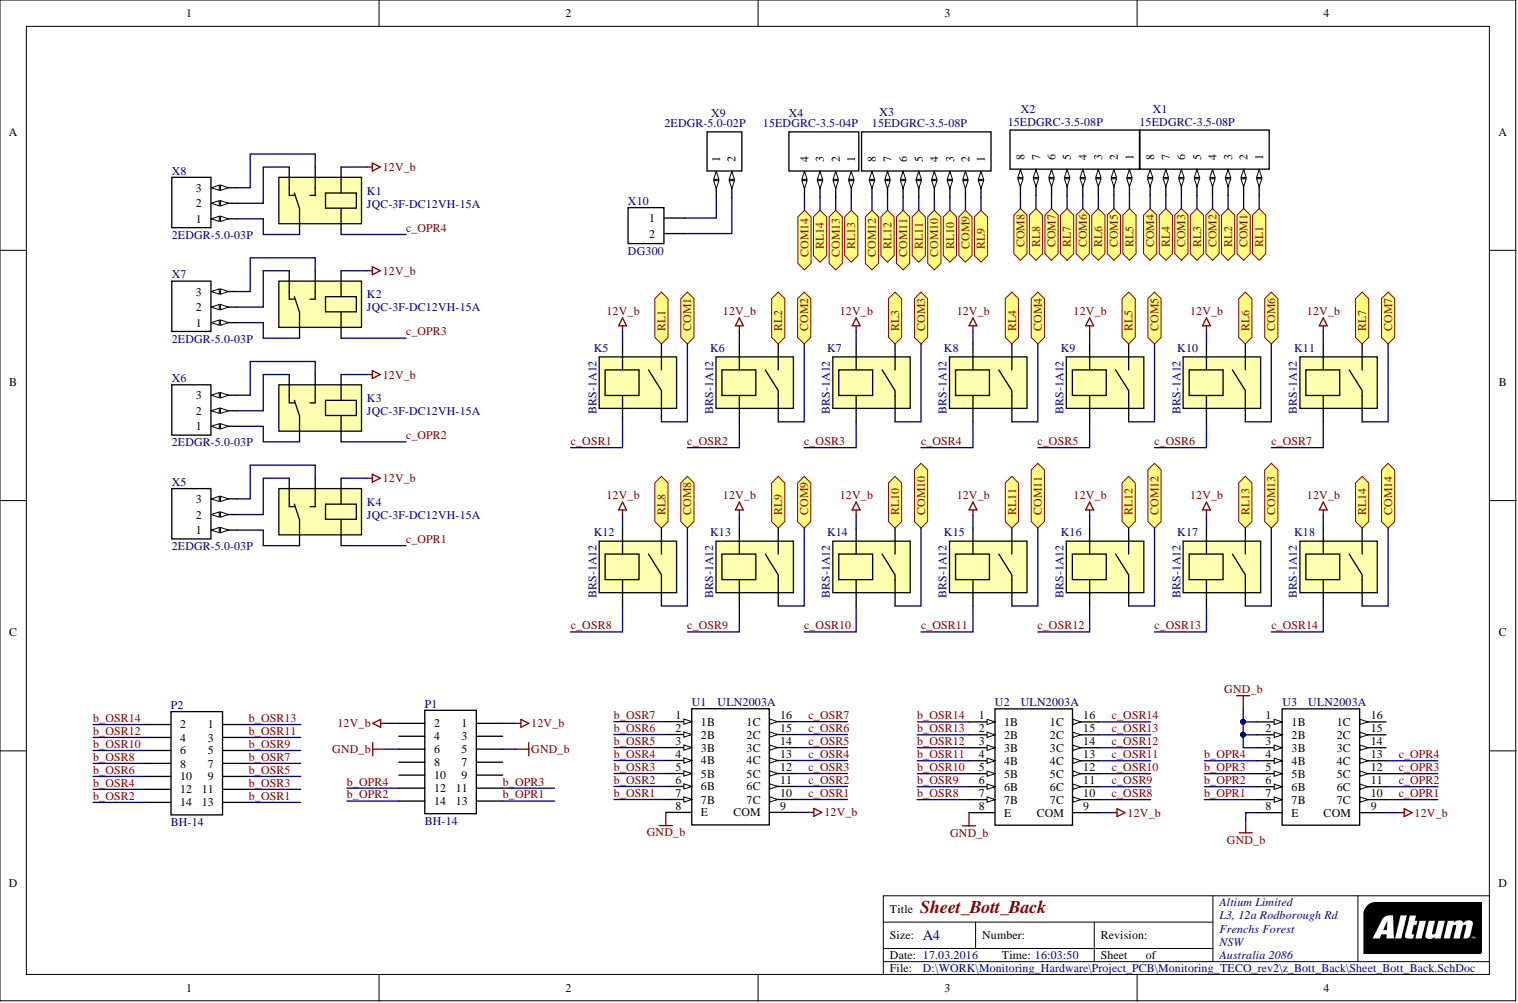
[picture p13: page 1]

Title Sheet_Bott_Back | Altium Limited L3, 12a Rodborough Rd Frenchs Forest NSW Australia 2086

Size: A4 | Number: | Revision:
Date: 17.03.2016 Time: 16:03:50 | | Sheet of
