ComEngineering/Monitoring_Hardware/Project_PCB/Monitoring_TECO_rev2/DOC/Sheet_SM-OW2.DI4.DCI4 rev. 2.PDF

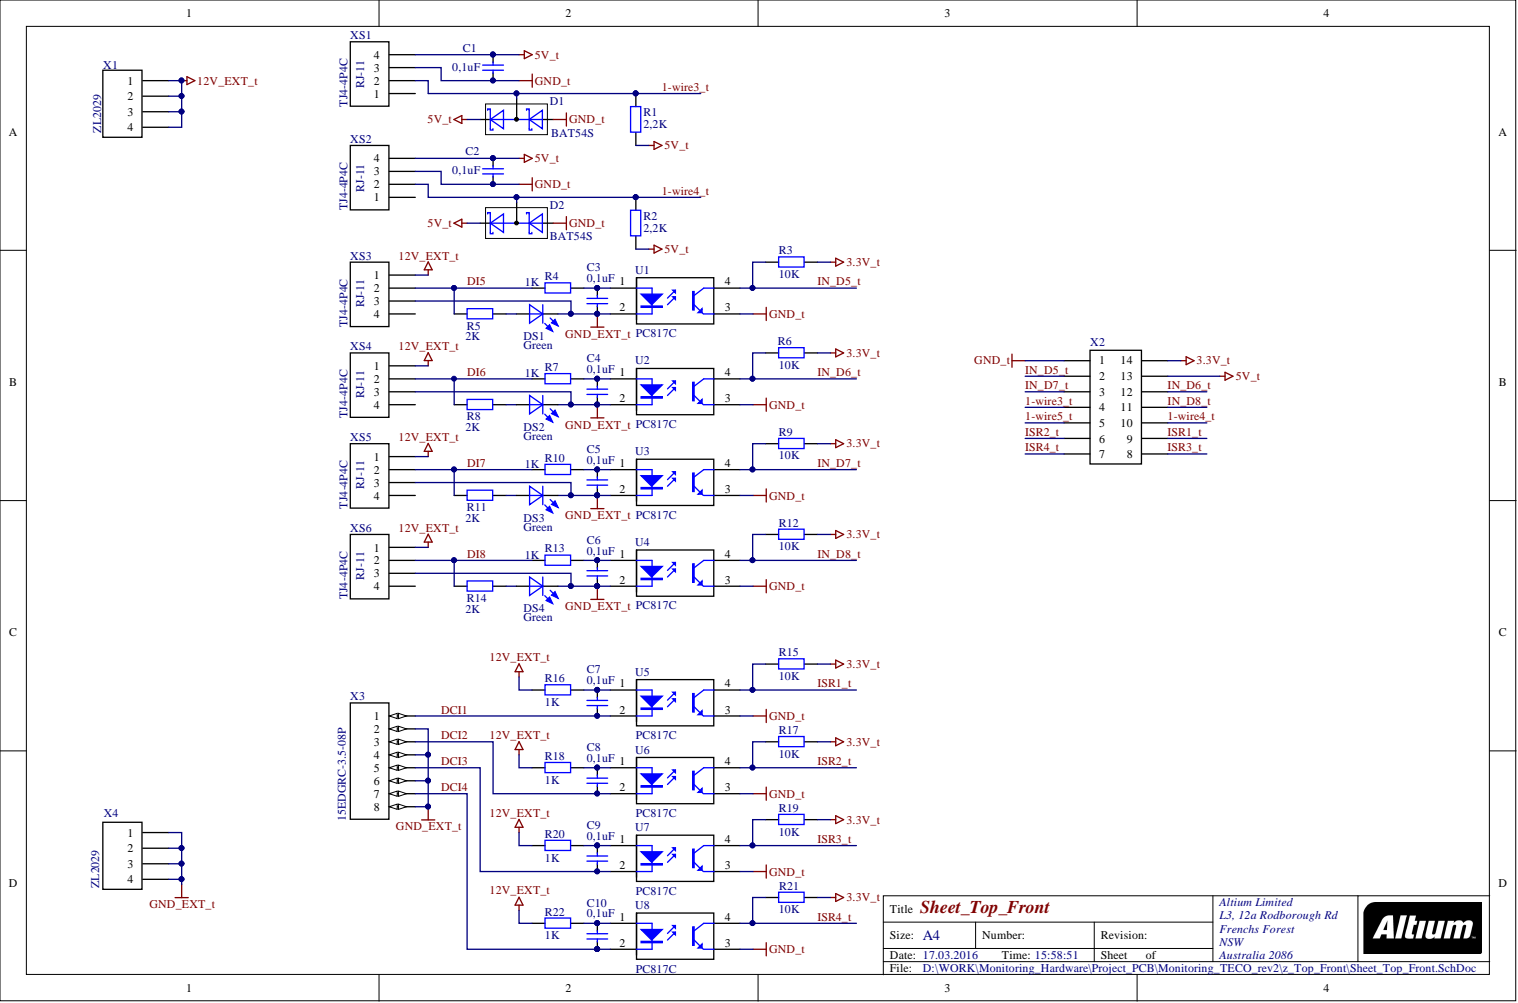
[picture p14: page 1]
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

Size: A 4 | N umber: | Rev i s i o n :
Date: 1 7.0 3.2 0 1 6 T ime: 1 5 : 5 8 : 5 1 | | Sheet o f
