ComEngineering/Monitoring_Hardware/Project_PCB/Monitoring_TECO_rev2/z_ConnectA10/Project Outputs for ConnectA10/Sheet_SM-Connect Olimex rev. 2.PDF

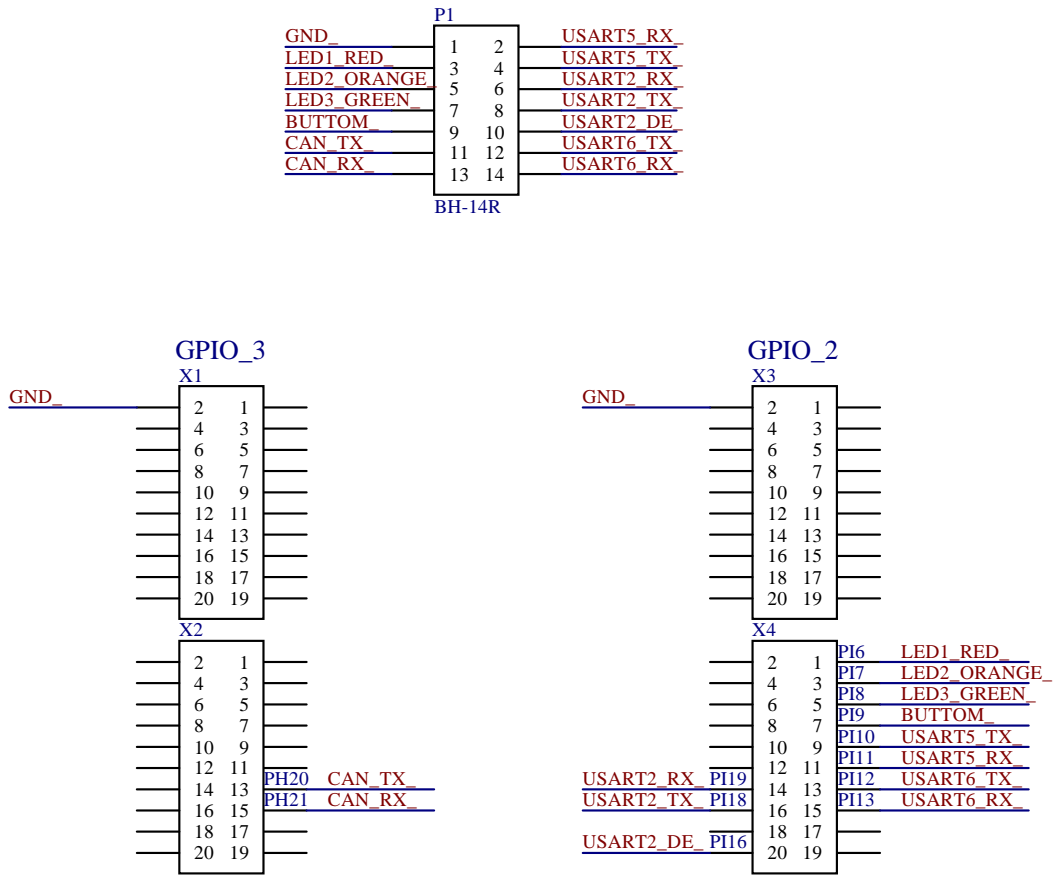
[picture p15: page 1]

Title Sheet_ConnectA10 | Altium Limited L3, 12a Rodborough Rd Frenchs Forest NSW Australia 2086

Size: A4 | Number: | Revision:
Date: 17.03.2016 Time: 16:02:50 | | Sheet of
