ComEngineering/Monitoring_Hardware/Project_PCB/Monitoring_TECO_rev1/DOC/PCB_Connect.pdf

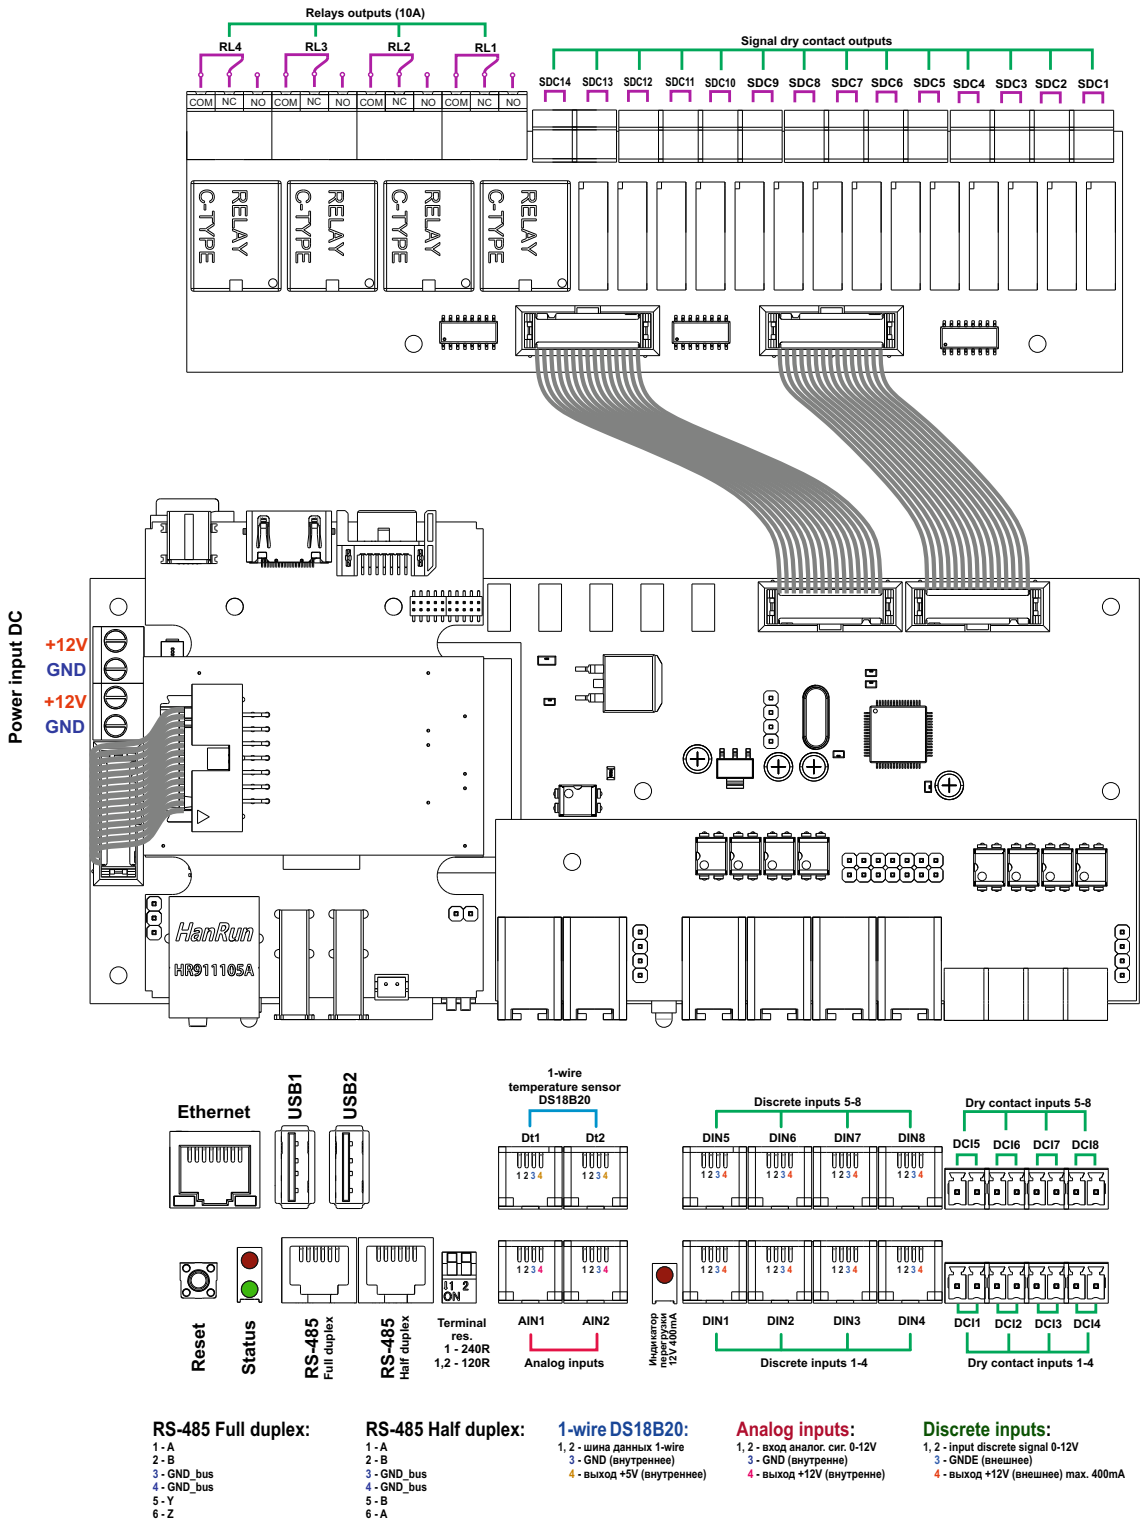
[picture p16: page 1]
+12V GND; Ethernet; USB1; USB2; Full duplex; Half duplex; AIN1; Analog inputs; DIN5; DIN6; DIN7; DIN8; DIN1; DIN2; DIN3; DIN4; Terminal res. 1 - 240R 1,2 - 120R; Reset; Status; 1-wire temperature sensor; Discrete inputs 5-8; Discrete inputs 1-4; DCI5 DCI6 DCI7 DCI8; DCI1 DCI2 DCI3 DCI4; SDC14 SDC13 SDC12 SDC11 SDC10 SDC9 SDC8 SDC7 SDC6 SDC5 SDC4 SDC3 SDC2 SDC1; Relays outputs (10A); Power input DC; COM NC; NO COM NC; 1-wire DS18B20:; 1 - A 2 - B 3 - GND_bus 4 - GND_bus 5 - B 6 - A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

Signal dry contact outputs

Dry contact inputs 5-8

4 - выход +5V (внутреннее) Индикатор перегрузки 12V ⁴⁰⁰mA
AIN2

Dry contact inputs 1-4

RS-485 Full duplex:

RS-485 Half duplex:

Analog inputs:
1, 2 - вход аналог. сиг. 0-12V
3 - GND (внутренне)
4 - выход +12V (внутренне)

Discrete inputs:
1, 2 - input discrete signal 0-12V
3 - GNDE (внешнее)
4 - выход +12V (внешнее) max. 400mA

1, 2 - шина данных 1-wire
3 - GND (внутреннее)
