ComEngineering/Monitoring_Hardware/Project_PCB/Monitoring_TECO_rev1/DOC/Monitoring.PDF

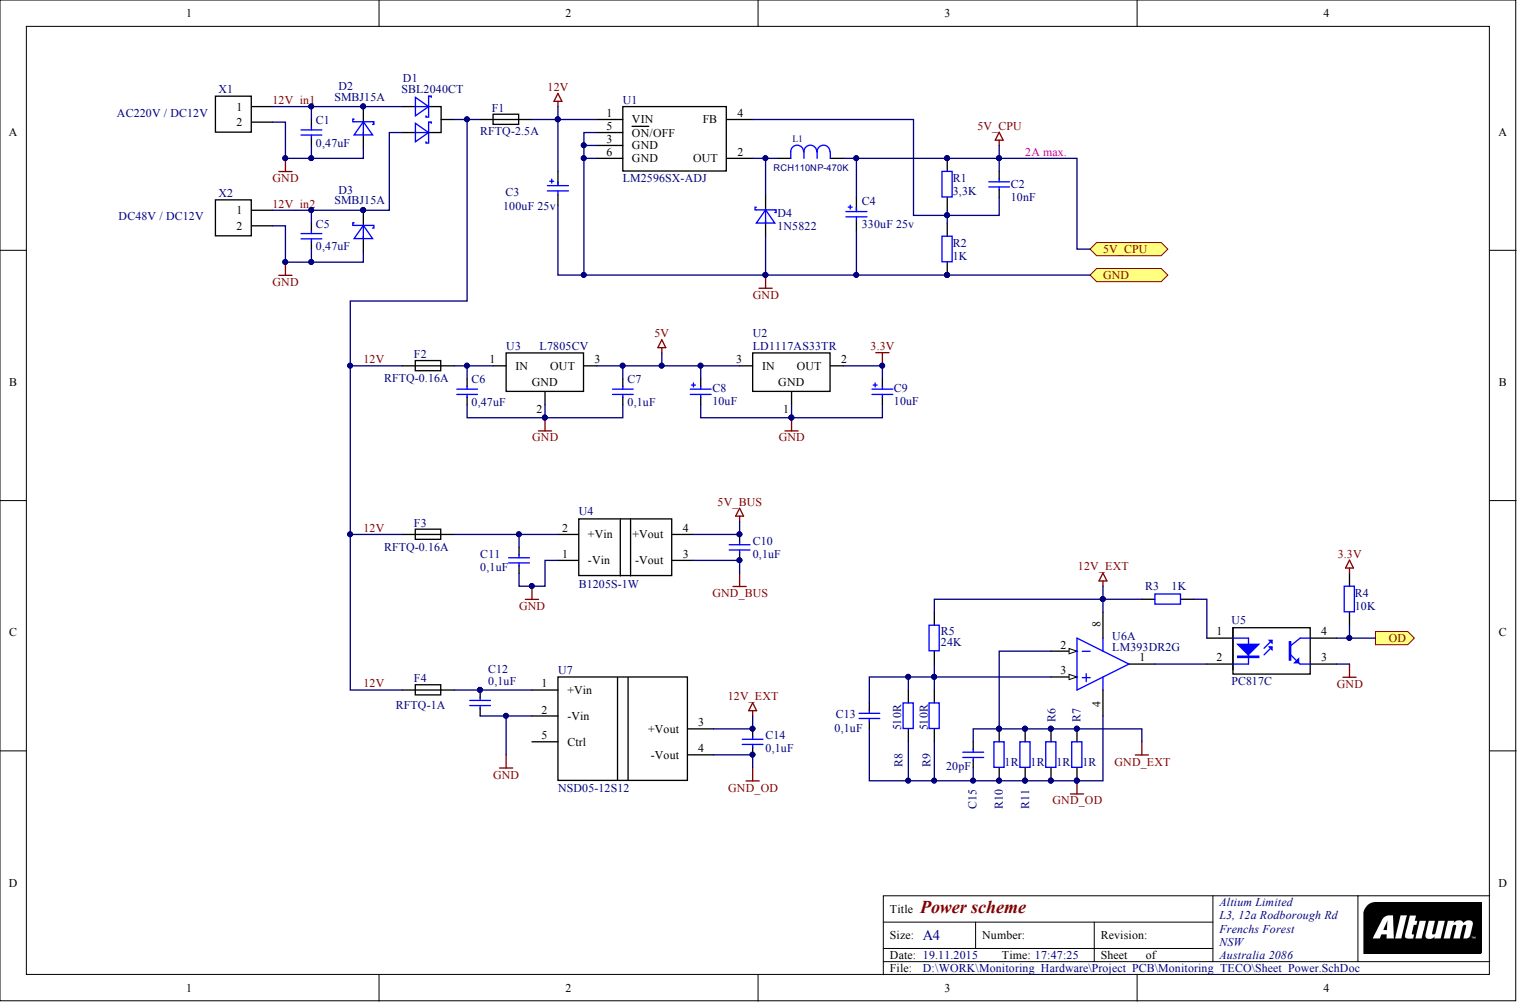
[picture p17: page 1]

ON/OFF 5
GND 3
GND 6

+Vin 2

12V | -Vin 1

+Vin 1

Ctrl 5

Title Power scheme | Altium Limited L3, 12a Rodborough Rd Frenchs Forest NSW Australia 2086

Size: A4 | Number: | Revision:
Date: 19.11.2015 Time: 17:47:25 | | Sheet of

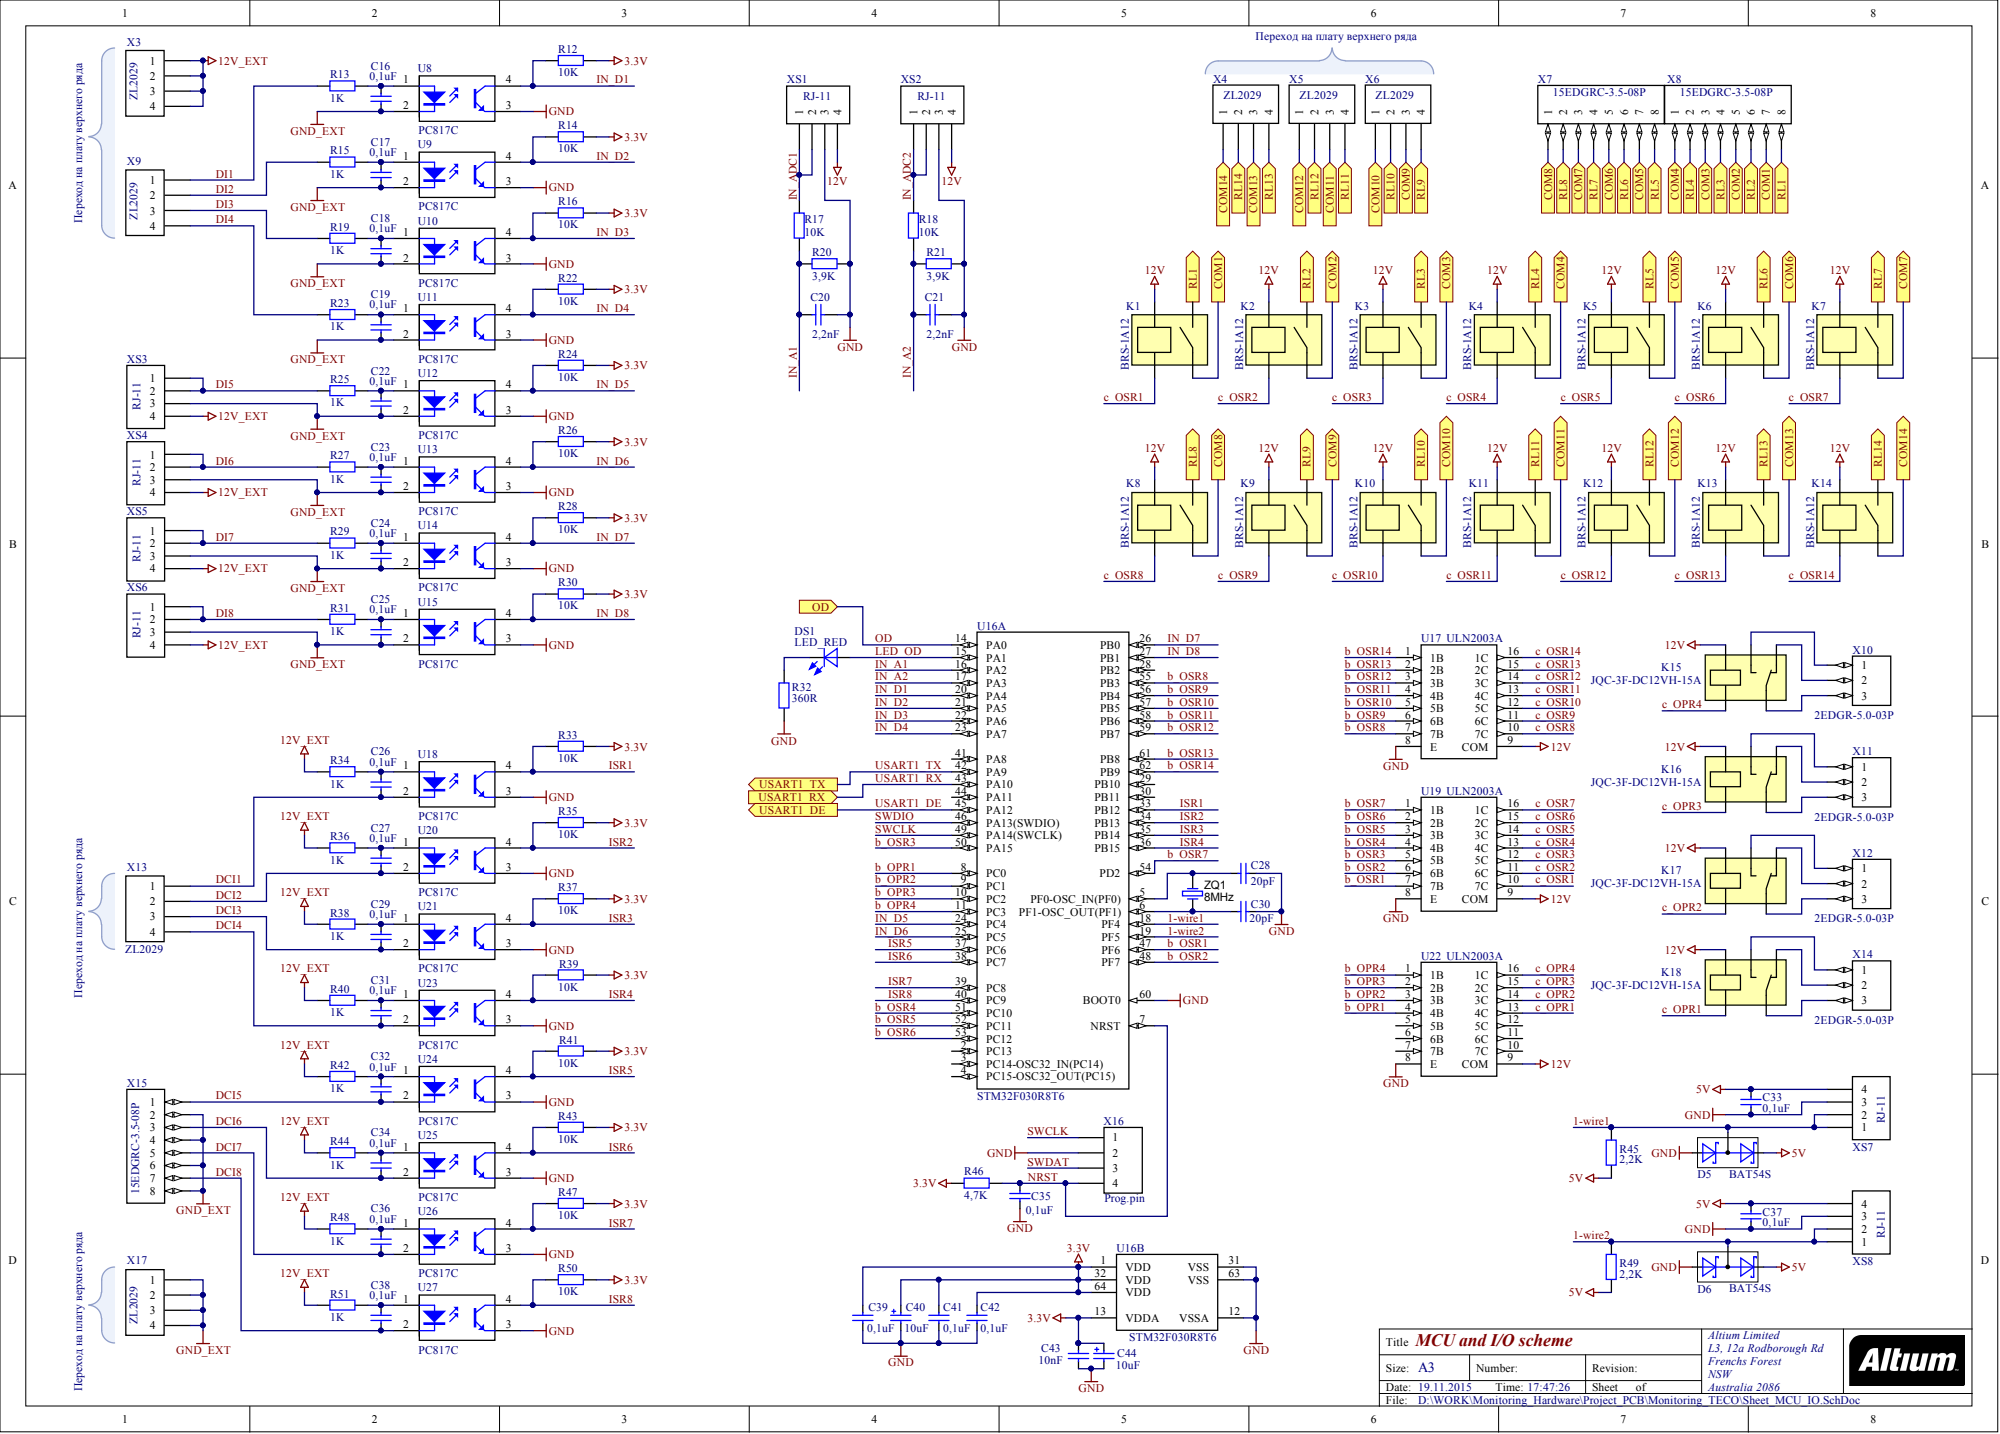
[picture p18: page 2]

Переход на плату верхнего ряда Переход на плату верхнего ряда Переход на плату верхнего ряда

USART 1 _RX | 4 3 | 2 9

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

Size: A | N umber: | Rev i s i o n :

T ime: | | Sheet o f

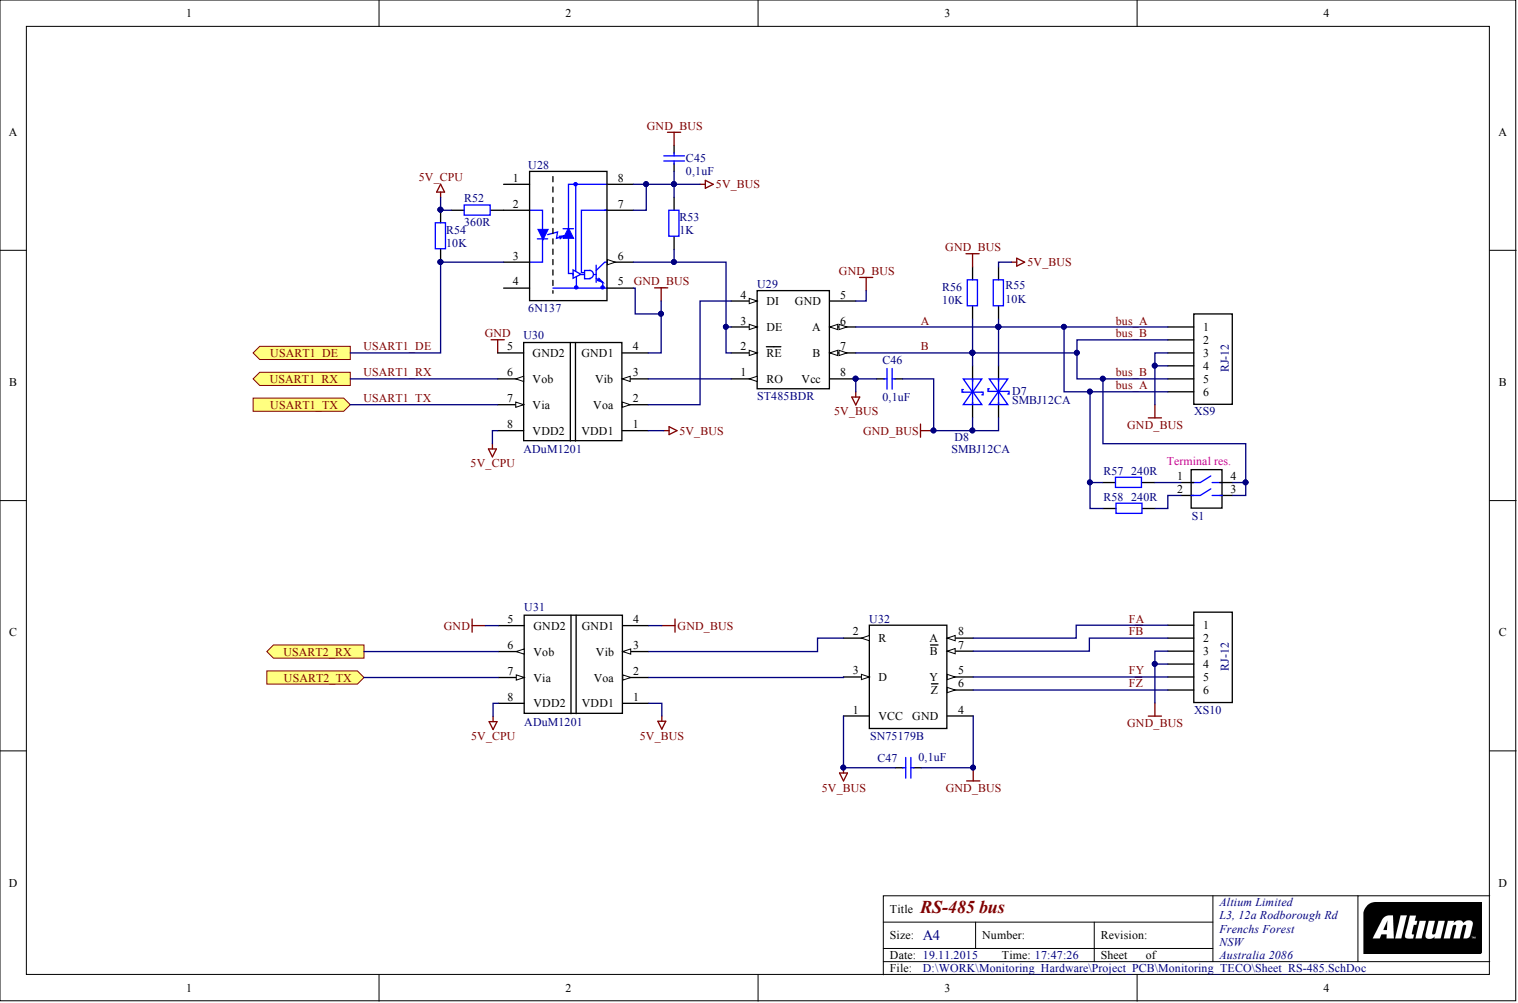
[picture p19: page 3]

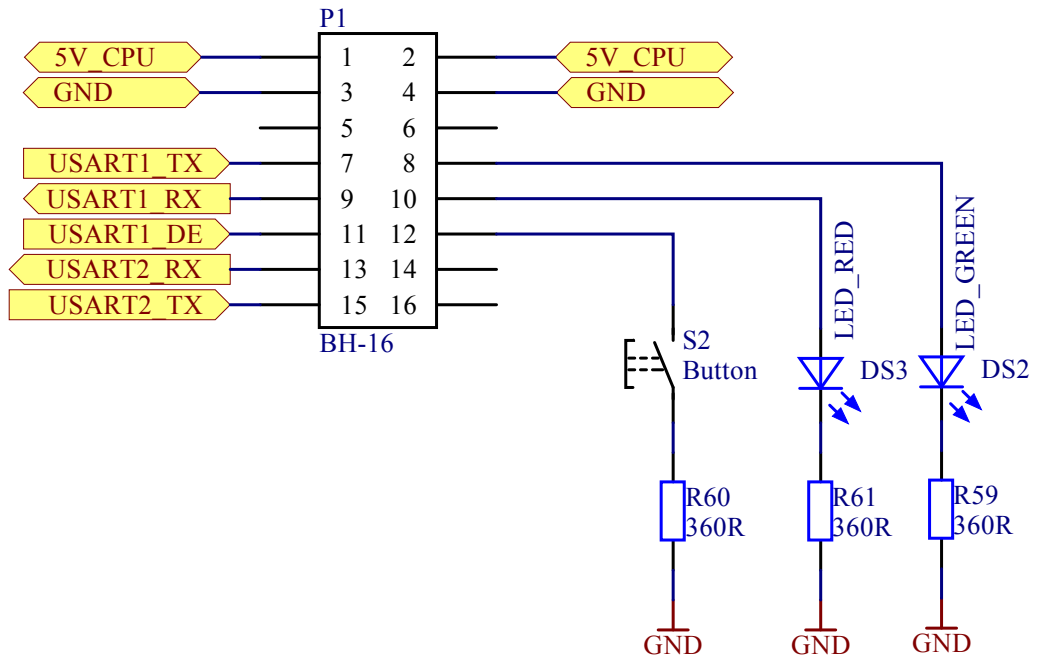
[picture p20: page 4]

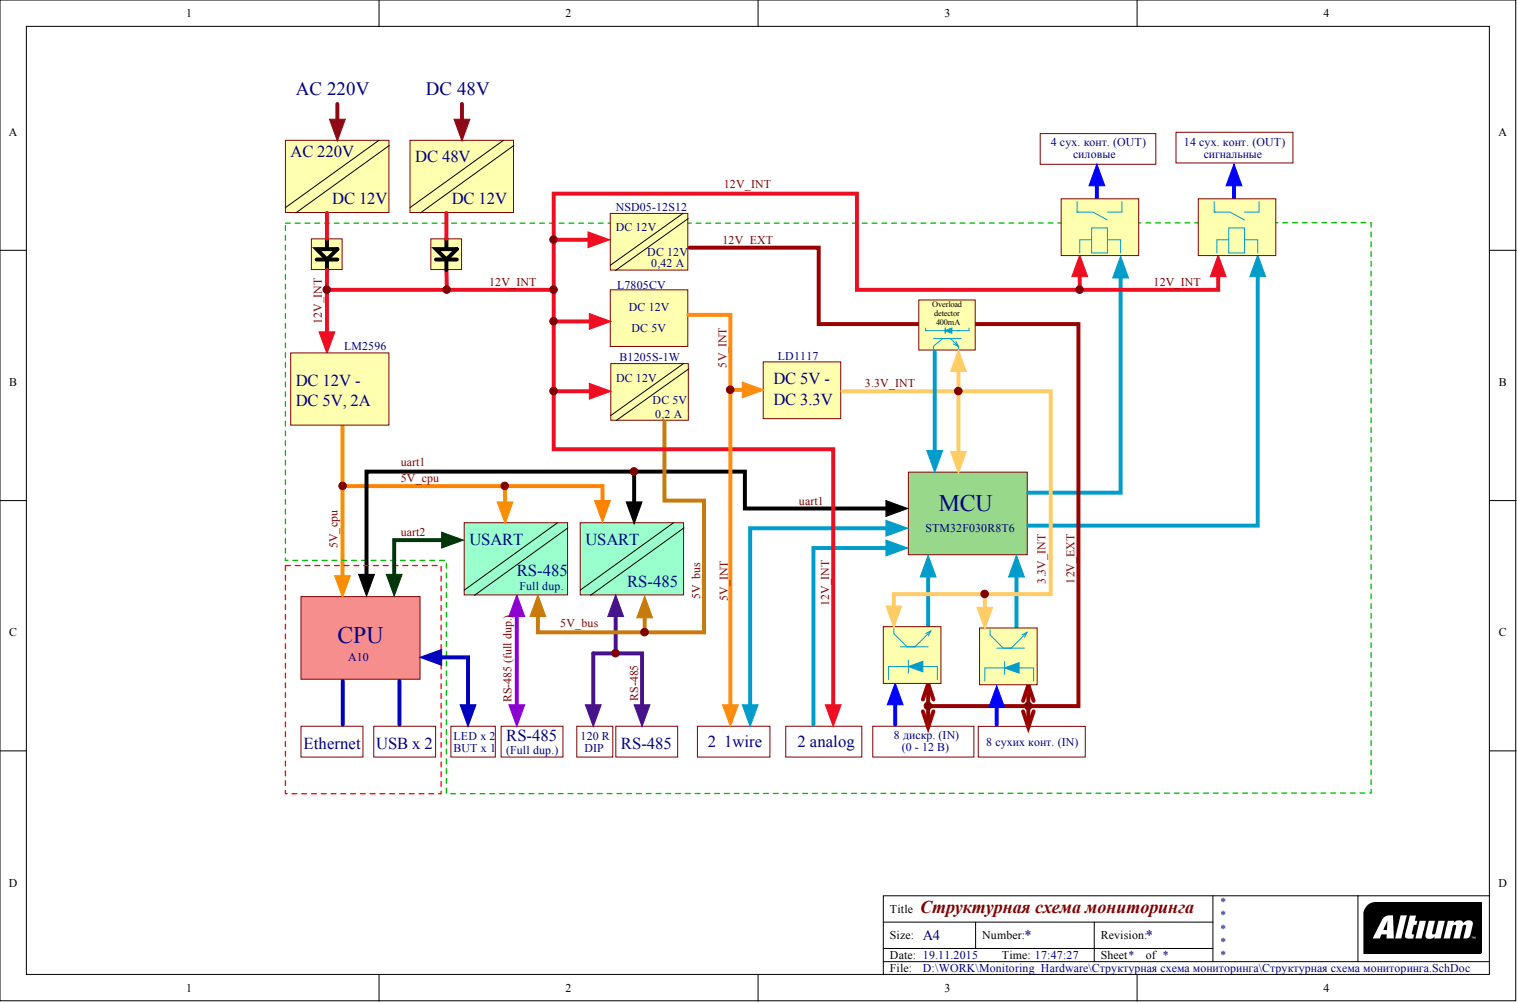
[picture p21: page 5]

DC 1 2 VDC 5 | | DC 5V -

Size: A | N umber: | Rev i s i o n :

T ime: | | Sheet * o f *
