ComEngineering/Monitoring_Hardware/(list of files, drawings)

Other design files:
Project_PCB/Monitoring_TECO/A10-OLinuXino-LIME.PcbDoc
Project_PCB/Monitoring_TECO/PCB_monitoring_IO.PcbDoc
Project_PCB/Monitoring_TECO_rev1/Monitoring_TECO_rev1.PrjPcb
Project_PCB/Monitoring_TECO_rev1/PCB_monitoring_Bott_Back.PcbDoc
Project_PCB/Monitoring_TECO_rev1/PCB_monitoring_ConnectA10.PcbDoc
Project_PCB/Monitoring_TECO_rev1/Sheet_Bott_Back.SchDoc
Project_PCB/Monitoring_TECO_rev1/Sheet_ConnectA10.SchDoc
Project_PCB/Monitoring_TECO_rev1/Sheet_MCU_IO.SchDoc
Project_PCB/Monitoring_TECO_rev1/Sheet_Power.SchDoc
Project_PCB/Monitoring_TECO_rev1/Sheet_Top_Front.SchDoc
Project_PCB/Monitoring_TECO_rev1/Структурная схема мониторинга/Структурная схема мониторинга.SchDoc
Project_PCB/Monitoring_TECO_rev2/Monitoring_TECO_rev2.PrjPcb
Project_PCB/Monitoring_TECO_rev2/Sheet_MCU_IO.SchDoc
Project_PCB/Monitoring_TECO_rev2/Sheet_Power.SchDoc
Project_PCB/Monitoring_TECO_rev2/z_Bott_Back/Bott_Back.PrjPcb
Project_PCB/Monitoring_TECO_rev2/z_Bott_Back/PCB_monitoring_Bott_Back.PcbDoc
Project_PCB/Monitoring_TECO_rev2/z_Bott_Back/Sheet_Bott_Back.SchDoc
Project_PCB/Monitoring_TECO_rev2/z_ConnectA10/ConnectA10.PrjPcb
Project_PCB/Monitoring_TECO_rev2/z_ConnectA10/PCB_monitoring_ConnectA10.PcbDoc
Project_PCB/Monitoring_TECO_rev2/z_ConnectA10/Sheet_ConnectA10.SchDoc
Project_PCB/Monitoring_TECO_rev2/z_Top_Front/PCB_monitoring_Top_Front.PcbDoc
Project_PCB/Monitoring_TECO_rev2/z_Top_Front/Sheet_Top_Front.SchDoc
Project_PCB/Monitoring_TECO_rev2/z_Top_Front/Top_Front.PrjPcb
Project_PCB/Monitoring_TECO_rev2/Структурная схема мониторинга/Структурная схема мониторинга.SchDoc
