ComEngineering/Monitoring_Hardware/(commit log)

2015-10-28 Added folder with hardware scheme and folder datasheet
    [Monitoring_TECO.PrjPcb, Sheet_MCU_IO.SchDoc, Sheet_Power.SchDoc]
2016-01-11 Add version
    [Monitoring_TECO.PrjPcb, PCB_monitoring_Bott_Back.PcbDoc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]
